status-im/keycard-pro/(threads)

Thread 14 (2025-03-18):

Timeout too long if card inserted wrong way

bitgamma, 2025-03-18:
Turning the device one with the card in the wrong direction seems to have a longer than expected timeout before an error appears

bitgamma, 2025-05-13:
the culprit was a 30 second timeout in the smartcard code, now lowered to 1 second

Closed 2025-05-13.

Thread 20 (2025-04-09):

Implement e-label

bitgamma, 2025-04-09:
details tbd

guylouis, 2025-07-13:
**Context**
Products sold in europe and in the usa need a list of mandatory mentions on the product like
CE mark
barred bin
model number
name of the manufacturer
power rating
serial or lot number

Products who have a display can use the display to show these informations instead of printing them on the product.

**For Shell**
On Shell we will have the CE mark and trashed bin. Both on the PCB behind the battery. But not the rest of theinformations.

So we have to create a menu, accessible when the product is unlocked.

**To be confirmed (I will be able to conifrm week of 28/7/2025)**
- place and name for the menu (probably will be something like settings/device/legal) I have to check what's the tolerated maximum number of clicks to get to the menu
- content of the screen. Hopefully it will be only text (since CE and barred bin are already on the product), and the only variable one will be the SN of the device

guylouis, 2025-07-30:
**Regarding where to put this elabel, the reference docs are**

https://fcc.report/FCC-ID/A4RGUIK2/5042986.pdf

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

So I suggest to put it here: settings/device/**regulatory label**

**Regarding the content of the label it should be**

"
Brand: Keycard
Model: Shell
Input: 5V DC, 1A
Manufacturer: Status Research and Development Am Zirkus 2, D-10117 Berlin, Germany
Made in China
Serial number:xxxxxxx
"

note: actually I think the input could take up to 1.5A but we can play it safe and leave 1A here

bitgamma, 2025-08-11:
done

Thread 23 (2025-04-09):

support SeedQR and text-mnemonic QR

bitgamma, 2025-04-09:
add support for https://github.com/SeedSigner/seedsigner/blob/dev/docs/seed_qr/README.md and/or plaintext mnemonic QR.

bitgamma, 2025-06-25:
proposed (and currently implemented) interaction. The default choice is "with passphrase" since it seems to be very common to set one when using SeedQR.

Please review @xAlisher @guylouis:

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

xAlisher, 2025-06-26:
@guylouis @bitgamma

Following up on the conversation here:
[https://discord.com/channels/1366754869561790474/1387350462117712045/1387690470423007333](https://discord.com/channels/1366754869561790474/1387350462117712045/1387690470423007333)

I’m aligned with @bitgamma on the minor copy updates.

User flows have been added to Figma:
[https://www.figma.com/design/I4NT4JGHDEVSQ2yo5Z4mju/Shell-OS?node-id=5295-93739\&t=PKWxt5CPmQwZbo0K-1](https://www.figma.com/design/I4NT4JGHDEVSQ2yo5Z4mju/Shell-OS?node-id=5295-93739&t=PKWxt5CPmQwZbo0K-1)

Great job on this feature! 👏

Thread 27 (2025-05-06):

Improve T=1 support

bitgamma, 2025-05-06:
Smartcard from manufacturers other than NXP currently do not work properly with Shell. ATR and PPS seem to work, but T=1 blocks cannot be correctly exchanged, will have to check what's wrong.

Closed 2025-05-19.

Thread 29 (2025-05-14):

Update auto-complete interaction and feedback design

xAlisher, 2025-05-14:
### Title
Update auto-complete interaction and feedback design

---

### Description
The current auto-complete input flow is not intuitive for many testers.

**Reported by:** 9 testers

#### Key issues:
- It’s unclear what happens when users hold to save a word — most testers only understood it after experimenting.
- Selecting a suggested word feels confusing; several testers tried using arrow keys to confirm.
- Typing is slow and lacks visible feedback for how suggestions are selected or confirmed.

---

### Suggested improvements:
- Improve on-screen labels and titles for clarity
- Display a visible list of suggested words
- Add a walkthrough video or animation to onboarding materials
- Show a validation error (e.g. red text) if a user tries to confirm an invalid word

### Resources
https://www.figma.com/design/I4NT4JGHDEVSQ2yo5Z4mju/Shell-OS?node-id=0-1

xAlisher, 2025-05-24:
Plan Minimum
- Update wording to make expected behavior explicit.
- Improve readability of titles and the highlighted word segment.
- Clarify action label to reinforce what’s being confirmed.
- Increase space between cursor and word parts for readability

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

Plan Maximum

**Introduce an alternate suggestion input:**
- Show a full list of valid words to choose from.
- Reduce number active keys with every character selected to minimize navigation steps.

Overview
This update targets common tester friction in the current flow. Plan minimum is low-effort and already resolves major confusion. Plan maximum adds predictability and significantly faster word input.

Proposal: https://www.notion.so/Shell-input-improvements-14d8f96fb65c80f0bf76ff1ff1190570  (note: design and keyboard layout outdated)
Figma https://www.figma.com/design/I4NT4JGHDEVSQ2yo5Z4mju/Shell-OS?node-id=5055-140967&t=5ZdeBNICwB1bczF1-1

🙏👁️ @guylouis @bitgamma

xAlisher, 2025-05-24:
Error handling:
- Remove "Hold to" button

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

bitgamma, 2025-05-29:
extracted in #111  the more complete autocomplete solution

bitgamma, 2025-05-29:
implemented the minimum solution, however the "Hold to confirm label" actually doesn't fit in screen so I left the current label for the action label

bitgamma, 2025-06-04:
In code the space between navigation icon and screen border is 16px. The space between icon and label is 10px. I can decrease them if needed

Closed 2025-06-23.

Thread 30 (2025-05-14):

Standardize confirmation interaction using button 5 and OK button on virtual keyboard

xAlisher, 2025-05-14:
### Description
Several testers expected the center key (`5`) to act as a confirmation button, aligning with familiar patterns from TV remotes and keypad-based devices.

**Reported by:** 7 testers

#### Key issue:
- Users instinctively pressed button 5 to confirm actions during input flows.
- Current behavior is inconsistent and breaks expected interaction patterns.

### Suggested improvements:
- Map confirmation consistently to button 5 across keyboard interactions.
- Ensure the “OK” button performs the same role on relevant screens.

Closed 2025-09-08.

Thread 31 (2025-05-14):

Fix unpredictable focus behavior in virtual keyboard

xAlisher, 2025-05-14:
### Description
The current focus navigation in the virtual keyboard is unintuitive and frustrating for users.

**Reported by:** 7 testers

#### Key issues:
- Focus does not move as expected when navigating the keyboard.
- The current layout appears designed for symmetry rather than interaction flow.
- Testers often lost track of which key will be active or selected.

---

### Suggested improvements:
- Prioritize predictable navigation over visual symmetry.
- Align key positions to support consistent up/down/left/right movement.
- Consider visual or motion cues to reinforce active focus.

---

### Resources
https://www.figma.com/design/I4NT4JGHDEVSQ2yo5Z4mju/Shell-OS?node-id=0-1

guylouis, 2025-05-23:
I personally think option 2 makes more sense, but it's not either a blocker for release. It comes down to @bitgamma bandwidth, if it's like less than 2 days of work I'd do it before release. Otherwise I think we can either postpone or expect someone else in the community takes it

Closed 2025-06-03.

Thread 32 (2025-05-14):

Consider supporting T9-style or multi-tap input method

xAlisher, 2025-05-14:
### Description
Several testers expected a classic SMS-style input method, where each number key maps to multiple letters (e.g., button 1 circles through  A,B,C). The current input model does not meet this expectation and slows down entry for many users.

**Reported by:** 6 testers

#### Key issues:
- Testers instinctively expected to use multi-tap or classic T9 logic for typing.
- The current flow doesn’t align with familiar mobile or remote control inputs.
- This mismatch leads to user frustration and slower task completion.

---

### Suggested improvements:
- Implement a T9-style layout or offer it as an optional input mode.
- Visually indicate available letters per button.
- Consider pairing with predictive suggestions for efficiency.
- Consider updating physical buttons with related letters

---

### Resources
https://www.figma.com/design/I4NT4JGHDEVSQ2yo5Z4mju/Shell-OS?node-id=0-1

Thread 33 (2025-05-14):

Fix Shell shutdown caused by loose Keycard connection

xAlisher, 2025-05-14:
### Description
Shell powers off when the Keycard moves slightly during use. This disrupted testing sessions and led testers to question the device’s reliability.

**Reported by:** 5 testers

#### Key issues:
- Card doesn’t stay securely in place.
- Minor shifts in the card's position result in an unexpected power-off.

---

### Suggested improvements:
- Improve card slot tension to ensure stable connection.
- Add visual feedback to confirm successful card insertion.
- Explore mechanical design changes to prevent unintentional disconnection.

guylouis, 2025-05-23:
taken into account in the various mechanical adjustments decided based on those alpha/er prototypes

the changes are documented here

[Mechanical adjustments to Shell ER_alpha stage 05 2025.pdf](https://github.com/user-attachments/files/20414238/Mechanical.adjustments.to.Shell.ER_alpha.stage.05.2025.pdf)

Thread 34 (2025-05-14):

Ensure consistent navigation and visible Back button across all screens

xAlisher, 2025-05-14:
### Description
Testers experienced confusion due to inconsistent navigation patterns and missing “Back” buttons on several screens.

**Reported by:** 5 testers

#### Key issues:
- “Back” button not present or visible on all screens.
- Inconsistent navigation makes it hard to return to the previous step.
- Users were unsure how to exit or undo actions in certain flows.

---

### Suggested improvements:
- Standardize the presence and placement of the Back button across all screens.
- Use consistent icons or labels for navigation actions.
- Add visual guidance to reinforce expected flows and transitions.

---

### Resources
https://www.figma.com/design/I4NT4JGHDEVSQ2yo5Z4mju/Shell-OS?node-id=0-1

bitgamma, 2025-05-28:
lgtm

Closed 2025-05-28.

Thread 36 (2025-05-14):

Improve clarity of card orientation and insertion depth

xAlisher, 2025-05-14:
### Description
Users were uncertain about how far to insert the Keycard and which direction it should face. The current design provides limited tactile or visual guidance, leading to hesitation and errors during setup.

**Reported by:** 4 testers

#### Key issues:
- No clear indicator for proper card orientation.
- Lack of tactile or visual confirmation when the card is fully inserted.
- Some users feared inserting the card incorrectly or not far enough.

---

### Suggested improvements:
- Add visual cues (icons, arrows, notches) to indicate correct card direction and depth.
- Consider modifying slot design so a portion of the card remains visible after insertion.
- Include clearer onboarding steps or animations to guide first-time users.

xAlisher, 2025-05-19:
3 points of contact for chip orientation and insertion depth
- paper
- shape
- quick start guide

 For chip orientation
- it's not a Keycard or it's not inserted the right way

Thread 37 (2025-05-14):

Improve screen brightness for better visibility in varied lighting

xAlisher, 2025-05-14:
### Description
Testers reported that the screen was difficult to read in bright or direct lighting conditions. Low brightness affected usability, especially outdoors or in well-lit rooms.

**Reported by:** 3 testers

#### Key issues:
- Text and UI elements were hard to see in some environments.
- The screen didn’t adapt well to different lighting conditions.
- Diminished readability affected the overall impression of hardware quality.

---

### Suggested improvements:
- Enhance screen backlight strength or contrast.
- Explore using a brighter display panel.

guylouis, 2025-05-23:
after investigation, we confirmed that the transistor was not conducting properly because the control voltage (gate/base) was insufficient at 1.8 V

this happened because because between P2 (which was OK in terms of brightness) we changed the transistor reference, going back to the initial transistor on modified ER the backlight is OK

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

Thread 38 (2025-05-14):

Align physical button layout with on-screen label expectations

xAlisher, 2025-05-14:
### Description
Some testers expected the physical buttons to align directly beneath the on-screen labels. The current layout — where buttons are placed in the final row — caused mismatch and hesitation during interaction.

**Reported by:** 4 testers

#### Key issues:
- Mismatch between physical button placement and on-screen cues.
- Users looked for labels directly above buttons but found a disconnect.
- This slowed down interactions and created uncertainty during selection.

---

### Suggested improvements:
- Consider adjusting button placement to match the visual layout of the UI.
- Alternatively, improve visual guidance by clearly associating labels with their corresponding buttons.
- Highlight states and iconography to reinforce correct button-label mapping.

Thread 39 (2025-05-14):

Make battery easier to remove through design adjustment

xAlisher, 2025-05-14:
### Description
Several testers found it physically difficult to remove the battery from the device. The current design does not provide enough leverage or grip to extract it comfortably.

**Reported by:** 3 testers

#### Key issues:
- Battery is tightly fitted and lacks a convenient way to remove it.
- No designated area to grip or push the battery out.
- Frustration during basic maintenance impacts perceived usability.

---

### Suggested improvements:
- Add a notch, groove, or indentation to assist with finger grip.
- Consider introducing a pull tab or tool-free removal mechanism.
- Ensure that battery maintenance feels simple and intentional.

xAlisher, 2025-05-19:
It's possible to remove the battery with the card.
Add this to the doc.

guylouis, 2025-05-23:
conclusion is indeed that we won't make changes to the plastic but document precisely how to remove the battery

Thread 40 (2025-05-14):

Improve case material and surface finish for higher perceived quality

xAlisher, 2025-05-14:
### Description
Testers noted that the current plastic finish of the Shell case felt cheap. Several people expressed a desire for a more premium or tactile material.

**Reported by:** 3 testers

#### Key issues:
- Case surface feels generic or less durable.
- Glossy or smooth finish may reduce grip and aesthetic appeal.
- Material choice influences first impressions of quality.

---

### Suggested improvements:
- Explore matte finishes.
- Consider material swaps that improve grip and reduce glare.
- Test finish options with users to balance durability and feel.

guylouis, 2025-05-27:
On alpha products (ER) we use ABS plastic but the grain (finish) is not applied on the steel mold. That's why the surface has some marks. The finish is applied at the very last moment when all changes on the steel mold have been done.

Once it is applied, the plastic when injected will be perfect in terms of finish and quality

Thread 41 (2025-05-14):

Improve font legibility by increasing size

xAlisher, 2025-05-14:
### Description
A few testers mentioned that the current font size is too small, making it harder to read content comfortably during use.

**Reported by:** 3 testers

#### Key issues:
- Font appears too small on certain screens.
- Difficult to read for users with less-than-perfect vision.
- Affects usability during onboarding and input flows.

---

### Suggested improvements:
- Increase default font size across the UI where possible.
- Offer an adjustable font size setting in preferences.

bitgamma, 2025-07-14:
font size increased in titles

Closed 2025-07-14.

Thread 44 (2025-05-14):

Consider switching to alphabetical keyboard layout for clarity

xAlisher, 2025-05-14:
### Description
Some testers found the QWERTY layout less intuitive, especially on a small device with limited keys. An alphabetical layout might offer better clarity for non-technical or first-time users.

**Reported by:** 2 testers

#### Key issues:
- QWERTY layout is less familiar to some users in this context.
- Alphabetical layout may reduce friction and improve discoverability.
- Device constraints make traditional keyboard patterns feel unintuitive.

---

### Suggested improvements:
- Offer an alphabetical keyboard layout as default or as an option.
- Test with both experienced and non-experienced users to validate layout clarity.
- Explore hybrid layouts optimized for hardware button constraints.

---

### Resources
https://www.figma.com/design/I4NT4JGHDEVSQ2yo5Z4mju/Shell-OS?node-id=0-1

Thread 45 (2025-05-14):

Clarify whether user is creating a new PIN or entering an existing one

xAlisher, 2025-05-14:
### Description
Testers were confused about whether they were supposed to **create a new PIN** or **enter an existing one** when interacting with the first screen of the device. The word “Set” was used, but was not easily visible or meaningful in context.

**Reported by:** 2 testers

#### Key issues:
- Ambiguity between PIN creation and PIN entry on first use.
- The label “Set” is unclear and lacks visual emphasis.
- Confusion at this critical step can lead to hesitation or input errors.

---

### Suggested improvements:
- Use clear, explicit text: “Create new PIN” vs. “Enter existing PIN.”
- Improve visibility and contrast of instructional text on the screen.
- Consider using a visual indicator or icon to differentiate the flows.

---

### Resources
https://www.figma.com/design/I4NT4JGHDEVSQ2yo5Z4mju/Shell-OS?node-id=0-1

bitgamma, 2025-05-28:
implemented

Thread 46 (2025-05-14):

Improve button feel — reduce press resistance for better usability

xAlisher, 2025-05-14:
### Description
Several testers reported that the hardware buttons on Shell felt too stiff or hard to press. The high resistance reduced comfort and created hesitation during interactions.

**Reported by:** 2 testers

#### Key issues:
- Buttons require too much force to register input.

---

### Suggested improvements:
- Soften the button mechanism to reduce required pressure.
- Explore alternative materials or switch types for improved feel.
- Aim for a balance between clicky feedback and comfortable usability.

bitgamma, 2025-05-14:
8 testers explicitly mentioned liking the current level of stiffness

Thread 47 (2025-05-14):

Improve packaging usability — box is difficult to open and remove Shell from

xAlisher, 2025-05-14:
### Description
Testers reported difficulty both opening the Shell packaging and removing the device from the box. These friction points negatively impacted the unboxing experience and first impressions of the product.

---

#### Key issues:
- Outer box lacks intuitive opening mechanism; users had to guess or apply force.
- The Shell device is tightly fitted with no clear way to lift it out.
- Risk of user frustration or device damage during unboxing.

---

### Suggested improvements:
- Redesign the box for easier opening (e.g. tear strip, pull tab, or clear indicators).
- Add a finger recess, ribbon, or lift tab to help remove the Shell device easily.
- Prototype revised packaging for smoother, one-handed unboxing experience.

guylouis, 2025-05-14:
working on providing an improved version
- same construction philosophy
- with more room inside, will facilitate grabbing stuff
- with higher quality feeling of the material

1st step is to decide if we can keep the black & orange type of design and improve the perceived quality. It's unsure while using corrugated paper that we can manage too, because of the edges

If we can't we'll have cardboard color material on which we will print our design. It will help have a cleaner looking edge.

guylouis, 2025-05-23:
strategy is to create a place to put the finger to lift up Shell and the papers

[KEYCARD_coffret_v1_23052025.pdf](https://github.com/user-attachments/files/20414222/KEYCARD_coffret_v1_23052025.pdf)

guylouis, 2025-07-14:
packaging had been improved, see the die cut below
samples to be received end of July - early August max

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

Closed 2025-06-30.

Thread 48 (2025-05-14):

Clarify how to add Shell as a hardware wallet in MetaMask

xAlisher, 2025-05-14:
### Description
Testers were confused when attempting to connect Shell as a hardware wallet in MetaMask. MetaMask requires users to first create or import a hot wallet before they can add a hardware wallet — a step that’s not obvious to first-time users.

---

#### Key issues:
- Users didn't understand why MetaMask wouldn't let them add Shell directly.
- Lack of guidance led to friction and unnecessary troubleshooting.
- MetaMask UX assumption (hot wallet first) was not communicated clearly.

---

### Suggested improvements:
- Mention this requirement during Shell onboarding when prompting users to connect to MetaMask.
- Add a tip or note in Shell’s help documentation.
- Reach out to the MetaMask team with a proposal to improve or clarify this flow on their end.

Thread 49 (2025-05-14):

Improve readability of word prompt during backup flow

xAlisher, 2025-05-14:
### Description
During the backup process, users found it unclear which word they were expected to input. The current title bar, which displays the word number, is not easily readable due to low contrast.

---

#### Key issues:
- Word number (e.g. “Word 5”) is hard to see against the background.
- The label lacks contrast and visibility, leading to hesitation and confusion.
- Users are unsure which word they’re confirming or typing.

---

### Suggested improvements:
- Increase the contrast of the title bar
- Consider moving the word number to a more visible location, such as below the title
- Explore adding visual cues (like progress dots or highlighting) to reinforce the step number.

---

### Resources
https://www.figma.com/design/I4NT4JGHDEVSQ2yo5Z4mju/Shell-OS?node-id=0-1

xAlisher, 2025-05-24:
Suggest improving visibility without disrupting layout by:

- Increasing the title font size (may create slight tension in other areas, but it’s manageable).
- Boosting contrast between title text and background by brightening the style.

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

Bonus idea:
- To improve predictability, we could display the number of remaining steps to complete the flow.

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

🙏👁️ @bitgamma @guylouis

bitgamma, 2025-05-28:
@xAlisher lgtm, but I see in the figma design that some title needs to be changed because they don't fit with the larger font size.

Also, I see highlighted words/menus are now using white font instead of black. Is this change part of this issue?

Thread 50 (2025-05-14):

Clarify behavior of Cancel button on word input screen

xAlisher, 2025-05-14:
### Description
Testers were unsure what would happen if they pressed the “Cancel” button during the word input screen in the backup flow. The lack of explanation caused hesitation and fear of losing progress.

---

#### Key issues:
- “Cancel” button lacks contextual clarity — does it exit the flow, go back, or discard progress?
- Uncertainty at this step creates friction and user anxiety.
- No confirmation or explanation is provided when the button is pressed.

---

### Suggested improvements:
- Add a short label or tooltip to clarify what “Cancel” will do.
- Consider prompting a confirmation modal if pressing “Cancel” would result in data loss or reset.
- Use more descriptive text (e.g., “Go back” or “Exit backup”) if appropriate.

---

### Resources
https://www.figma.com/design/I4NT4JGHDEVSQ2yo5Z4mju/Shell-OS?node-id=0-1

phift, 2025-05-29:
Maybe that's what you mean by backup flow. But in the `Import recovery phrase` screen, 'c hold to exit' is similarly confusing, because holding c doesn't 'exit' the flow, but it returns to the previous screen

bitgamma, 2025-07-14:
labels have been adjusted accordingly

Closed 2025-07-14.

Thread 51 (2025-05-14):

Add support for displaying ABI data after scanning transaction QR

xAlisher, 2025-05-14:
### Description
Testers expressed interest in seeing decoded ABI (Application Binary Interface) data after scanning a transaction QR code. This would help verify the intent of a transaction before signing, especially for smart contract interactions.

#### Key issues:
- Lack of transparency into what the transaction is doing.
- Users want to understand the method and parameters before signing.
- No decoded ABI data currently shown in the signing flow.

---

### Suggested improvements:
- Parse and display ABI call data after scanning a transaction QR.
- Show method name, parameters, and values in a readable format.
- Include this as an optional step for advanced users.

---

### Resources
https://www.figma.com/design/I4NT4JGHDEVSQ2yo5Z4mju/Shell-OS?node-id=0-1

Thread 52 (2025-05-14):

Fix link to duress PIN documentation

xAlisher, 2025-05-14:
### Description
The link to the duress PIN documentation at [https://keycard.tech/duress_pin](https://keycard.tech/duress_pin) is currently broken or not live. Testers who try to learn more about this security feature encounter a dead page

**Reported by:** Multiple testers

#### Key issues:
- The link to duress PIN documentation leads to a non-functional page.
- Users are left without guidance on how duress mode works.
- Breaks the user flow during onboarding or help searches.

---

### Suggested improvements:
- Publish or finish the content at https://keycard.tech/duress_pin.

Closed 2025-08-11.

Thread 53 (2025-05-14):

Fix incorrect navigation when exiting “Generate New Key” flow

xAlisher, 2025-05-14:
### Description
When users exit the “Generate New Key” flow, they are redirected to the wrong screen. This creates confusion and breaks the expected flow continuity.

---

#### Key issues:
- Exiting the key generation process doesn’t return the user to the intended screen.
- Unexpected navigation causes users to feel lost or uncertain about their progress.
- Breaks consistency with the rest of the onboarding flow.

---

### Suggested improvements:
- Ensure exit from the “Generate New Key” flow returns the user to the correct previous screen.
- Review and test all exit paths for accuracy and UX coherence.

---

### Resources
https://www.figma.com/design/I4NT4JGHDEVSQ2yo5Z4mju/Shell-OS?node-id=0-1

xAlisher, 2025-05-19:
Let's test it

Thread 54 (2025-05-14):

Allow users to purchase Shell with cryptocurrency

xAlisher, 2025-05-14:
### Description
Testers expressed interest in buying Shell using crypto. Offering a direct crypto payment option would align with the values of the target audience and streamline the purchasing experience.

---

#### Key issues:
- No visible option to purchase Shell using crypto.
- Credit card-only checkout may exclude privacy-conscious or Web3-native users.
- Missed opportunity to align purchasing flow with the product’s ethos.

---

### Suggested improvements:
- Enable crypto payments via dedicated platform
- Highlight crypto payment option on the main landing and checkout pages.
- Allow pre-orders and community discounts through crypto-first channels.

Thread 55 (2025-05-14):

Clarify that “Get signature” in MetaMask triggers QR scanning flow

xAlisher, 2025-05-14:
### Description
Tester was confused by the “Get signature” button in MetaMask, as it’s not clear that clicking it will initiate the QR code scanning process with Shell. The lack of context causes hesitation and interrupts the expected signing flow.

---

#### Key issues:
- The label “Get signature” doesn’t indicate that it will trigger QR scanning.
- Users are unsure what to expect after clicking the button.
- Lack of explanation increases friction and makes the process feel opaque.

---

### Suggested improvements:
- Reach out to the MetaMask team to suggest a more descriptive label (e.g. “Scan to Sign” or “Continue with Hardware Wallet”).
- Include clear instructions in Shell documentation and onboarding to explain the MetaMask signing flow.

xAlisher, 2025-05-24:
To improve clarity and better align with MetaMask’s “Get Signature” prompt, I suggest updating the title on the TX QR screen.

Before:
“Scan signature QR with Wallet”

After:
“Show signature QR to your wallet”

This reinforces the correct direction of action and helps users interpret what’s happening more intuitively.

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

Thread 56 (2025-05-14):

Chevron-right inside the circle icon misinterpreted as  chevron on keypad

xAlisher, 2025-05-14:
### Description
Testers confused the chevron-right icon inside an orange circle with the physical chevron key on the keypad. This led to hesitation and incorrect inputs. The blending of icon roles reduced clarity in the interface.

#### Key issues:
- Chevron inside the orange circle is visually similar to the keypad's left-arrow button.
- Users mistakenly interpret it as a hardware control rather than an on-screen indicator.
- Inconsistent icon behavior breaks visual expectations.

---

### Suggested improvements:
- Consider using a plain orange circle for confirmation actions (OK), without overlaying the chevron.
- Keep all chevron icons on-screen consistently white.
- Ensure visual roles between hardware keys and on-screen symbols are clearly separated.

---

### Resources
https://www.figma.com/design/I4NT4JGHDEVSQ2yo5Z4mju/Shell-OS?node-id=0-1

xAlisher, 2025-05-23:
OK button states simplified and unified. Now we'll have only two states. Default and long press.

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

I need one more pair of eyes for feedback and review.
@guylouis @bitgamma

guylouis, 2025-05-23:
looks good!
maybe write it somewhere in the doc in a 'navigation' part of the faq

bitgamma, 2025-05-23:
looks good to me too

bitgamma, 2025-05-28:
done

Closed 2025-05-28.

Thread 58 (2025-05-14):

Allow adding a password to mnemonic

bitgamma, 2025-05-14:
often called the 13th or 25th word, we could allow the user to add a password the mnemonic phrase. This is especially useful if we implement #23 since it is relatively common to use a password in this case.

This step would happen during onboarding of a new card when:

- importing an existing mnemonic (either keyboard or QR)
- generating a new mnemonic, after backup and before the keys are actually loaded

bitgamma, 2025-06-09:
@xAlisher

my understanding is that in both generate mnemonic and import mnemonic the menu where you select the mnemonic length will become something like:

12 words
12 words + pass
24 words
24 words + pass

and that after the mnemonic has been entered or backed up the user will enter the pass.

Is this also how you see the flow? If that's the case I will start implementing this.

bitgamma, 2025-06-10:
Implemented the feature so that it at least works. For UI I simply modified the mnemonic length selection menu and added, in case an option with passphrase has ben selected, a final screen to input the passphrase. Feel free to revise this in any way

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

xAlisher, 2025-06-23:
@bitgamma design updated

Import recovery phrase https://www.figma.com/design/I4NT4JGHDEVSQ2yo5Z4mju/Shell-OS?node-id=5235-62008&t=4bPH3kMTDniDkBOV-1
Generate keys
https://www.figma.com/design/I4NT4JGHDEVSQ2yo5Z4mju/Shell-OS?node-id=214-58571&t=4bPH3kMTDniDkBOV-1

Closed 2025-06-23.

Thread 59 (2025-05-14):

Improve autocomplete prioritization to favor longer words

xAlisher, 2025-05-14:
### Description
Testers noted that Shell’s autocomplete often prioritizes shorter or less relevant words, even when longer, more complete matches are available. This results in more manual input and interrupts the typing flow.

#### Key issues:
- Autocomplete tends to suggest short or partial words first.
- Users expect longer, more specific matches to rank higher.
- Current ordering may lead to unnecessary corrections or delays.

---

### Suggested improvements:
- Adjust autocomplete algorithm to favor longer, more complete word matches.
- Test updated prioritization on common wallet recovery words

---

### Resources
https://www.figma.com/design/I4NT4JGHDEVSQ2yo5Z4mju/Shell-OS?node-id=0-1

Thread 60 (2025-05-14):

Clarify how to connect Shell to Rabby — no QR-based option visible

xAlisher, 2025-05-14:
### Description
Testers found it difficult to connect Shell to Rabby, as the wallet connection UI does not clearly show a QR-based option. Shell is not listed as a branded wallet, and there is no generic “Connect with QR” entry point, leading to confusion.

---

#### Key issues:
- Rabby does not show a generic QR-based connection option.
- Shell is not yet listed as a supported or branded wallet.
- Users struggle to find a compatible path for connection.

---

### Suggested improvements:
- Reach out to the Rabby team to request inclusion of Shell or a “Connect via QR” option.
- In the meantime, add a clear note in Shell documentation to guide users through the available workaround.
- Consider providing step-by-step instructions or visuals in onboarding for connecting via Rabby.

---

### Resources
https://www.figma.com/design/I4NT4JGHDEVSQ2yo5Z4mju/Shell-OS?node-id=0-1

Closed 2025-07-28.

Thread 61 (2025-05-14):

Add confirmation feedback after factory reset

xAlisher, 2025-05-14:
### Description
After performing a factory reset, the device does not provide any confirmation or feedback to indicate that the reset was successful. This leaves users unsure whether the action completed correctly.

---

#### Key issues:
- No success message, visual cue after reset.
- Users are left uncertain about whether the reset worked.
- Can lead to repeated attempts to enter previous PIN or loss of confidence in the process.

---

### Suggested improvements:
- Display a clear confirmation screen (e.g. “Keycard has been reset”) after the reset completes.
- Optionally add a success icon for reassurance.
- Then redirect users back to the welcome/setup screen after successful reset.

---

### Resources
https://www.figma.com/design/I4NT4JGHDEVSQ2yo5Z4mju/Shell-OS?node-id=0-1

xAlisher, 2025-05-21:
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

@guylouis @bitgamma  WDYT?

Closed 2025-05-28.

Thread 62 (2025-05-14):

Clarify wallet type selection (Ethereum, Bitcoin, Multichain)

xAlisher, 2025-05-14:
### Description
Testers were confused when asked to choose between Ethereum, Bitcoin, or Multichain wallets during setup. The options lacked context or explanation, making it unclear which one to pick.

---

#### Key issues:
- Users didn’t understand the differences between Ethereum, Bitcoin, and Multichain wallets.
- Lack of in-device guidance made this decision feel risky or arbitrary.
- No clear link to supported wallet features or compatibility.

---

### Suggested improvements:
- Add a brief description under each wallet type (e.g. “Ethereum: EVM-compatible chains”).
- Consider adding recognizable brand names (e.g. MetaMask, Rabby, OKX) to improve comprehension.
- Update documentation to explain each wallet type, use case, and compatibility in more detail.

---

### Resources
https://www.figma.com/design/I4NT4JGHDEVSQ2yo5Z4mju/Shell-OS?node-id=0-1

xAlisher, 2025-06-03:
- remove Sparrow
- remove multichain

xAlisher, 2025-06-23:
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

https://www.figma.com/design/I4NT4JGHDEVSQ2yo5Z4mju/Shell-OS?node-id=0-1&t=4bPH3kMTDniDkBOV-1

I'm suggesting to name most popular wallets right in the menu for better user experience.

@guylouis @bitgamma WDYT?

@cheny0 could you give me the list of wallets compatible with Shell sorted by popularity to add to this menu, please?

xAlisher, 2025-06-23:
https://www.figma.com/design/I4NT4JGHDEVSQ2yo5Z4mju/Shell-OS?node-id=53-19251&t=4bPH3kMTDniDkBOV-1

cheny0, 2025-06-25:
@xAlisher Here's a list in the current docs: https://keycard.tech/docs/supported-wallets#wallets-for-keycard. The "Multichain" QR code works for Bitget and backpack

guylouis, 2025-06-30:
I wouldn't trust this list too much, it was more a marketing list than a result of good testing

here's where we will track the result of the real testing
https://github.com/keycard-tech/keycard-shell/issues/81

guylouis, 2025-08-13:
So the entries will be:
Ethereum
Bitcoin
Bitcoin Multisig
Bitget

Bitcoin Testnet is present for now but will be removed before launch

guylouis, 2025-09-08:
I am unclear if it's ok like this (current implementation is ethereum, bitcoin, bitcoin multisig, bitget) or if we want to add more details in the list

Closed 2025-09-08.

Thread 63 (2025-05-14):

define keycard design for shell

guylouis, 2025-05-14:
When someone buys Shell, we will put 2 cards together within the box.

We need to define the packaging of these cards
- keycard logo be bottom front so that we see keycard logo when entering the card in shell
- black tone overall
- a shape should be present on the back that matches with Shell hole. This shape has several interest: care for the design (keycard and shell are perfect friends: they match :)), delimits a zone were the user could put a small sticker or write down with a marker a way to distinguish his cards, and finally helps remembering how (top/bottom) to insert the card.
- we want to keep our logistics wimple so this card will also be the one shipped to customers buying keycards without Shell

guylouis, 2025-10-03:
settled for this design [print_Keycard_K_icon_BLACK_V2.pdf](https://github.com/user-attachments/files/22676522/print_Keycard_K_icon_BLACK_V2.pdf)

Thread 66 (2025-05-14):

define exact content of the quick start 'card' printed in the box

guylouis, 2025-05-14:
content on alpha was:

front side

"Scan to get started
QR code
keycard.tech/start"

back side

"1 remove the back cover from keycard shell

2 install the battery in its slot

3 insert a keycard to turn on Keycard Shell
"

guylouis, 2025-05-30:
seems good to me, I guess the sensitive one is point 3. If one doesn't check the quick start guide then he must understand that he needs to push the card completely. So I guess point 3 should either
- have an illustration where we see the insertion top/bottom and a finger pushing all the way
- a text -> push card *all the way* or 'if your product doesn't turn on make sure you push the card all the way'

guylouis, 2025-07-13:
@Francesca-G

I think we're ready to design this, to print it also as part of the packaging
Could you do it when you have chance?

guylouis, 2025-07-28:
card updated by @Francesca-G

[TOKEA_carte_65x100mm.pdf](https://github.com/user-attachments/files/21468342/TOKEA_carte_65x100mm.pdf)

Closed 2025-07-28.

Thread 68 (2025-05-14):

message when inserting a card which is incompatible with keycard

guylouis, 2025-05-14:
can we review what happens if someone inserts a card without keycard applet, or with keycard applet but too old (applet < 3.1.0)

bitgamma, 2025-05-14:
sorry closed by mistake, but probably can be closed can't it?

guylouis, 2025-05-19:
some testers said the message was not super clear, may you confirm what it is in the code?

bitgamma, 2025-05-19:
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

guylouis, 2025-05-19:
we can close, I opened two issues for future improvements

not genuine: https://github.com/keycard-tech/keycard-shell/issues/72
old applet: https://github.com/keycard-tech/keycard-shell/issues/73

Closed 2025-05-19.

Thread 70 (2025-05-14):

Improve error message for unsupported Bitcoin Taproot transactions

xAlisher, 2025-05-14:
### Description
When attempting to sign a Taproot-based Bitcoin transaction using Shell and Unisat (e.g. for buying an ordinal on Magic Eden), the device displayed a misleading “wrong key pair” error. This happened even though the same Keycard worked for connecting to Unisat. The actual issue is related to Taproot being unsupported.

#### Context:
- Taproot is currently not supported.
- The transaction included Taproot components, leading to a signing failure.
- Error message displayed: “wrong key pair,” which does not explain the real cause.

---

### Suggested improvements:
- Update the error message to clarify that Taproot-based transactions are not supported.
- Suggested phrasing: _“This transaction uses a Taproot address, which is not supported yet.”_
- Optionally include a link to documentation or help page for supported address types.

---

### Notes:
Tested with:
- Shell + Unisat
- Magic Eden / Ordinal TX
- Switching to Segwit resolved the issue

---

### Resources
https://www.figma.com/design/I4NT4JGHDEVSQ2yo5Z4mju/Shell-OS?node-id=0-1

xAlisher, 2025-05-21:
> just update wording to a more generic error message to say that there is nothing we can sign here (it's not a question of keys)

But also could be a wrong key pair.
@guylouis @bitgamma WDYT?

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

guylouis, 2025-05-22:
seems good to me
how can we track all the things that need to be in the documentation ?
this is one for instance
any idea @cheny0 ?

cheny0, 2025-05-23:
@guylouis, what we are doing now seems to be good enough, which is to add the "documentation" label to relevant issues. When you want to check all documentation-related issues, you go to the project board and click on the "documentation" label. Then you'll see only issues with this label, like this https://github.com/orgs/keycard-tech/projects/1/views/1?filterQuery=label%3Adocumentation. WDYT?

guylouis, 2025-05-23:
great to hear!

bitgamma, 2025-05-28:
the subtext message is too long, otherwise I have to rework the entire info dialog to measure all text and calculate the vertical offsets before drawing, which I don't think it is worth. Let's omit the "Visit ..." part

Closed 2025-06-03.

Thread 76 (2025-05-19):

Update Shell packaging design

Francesca-G, 2025-05-19:
### Description

Update Shell packaging design

- **COLORS →** Natural cardboard color + orange 🟠
- **FLAPS →** need to be bigger and black (useful to protect the device)
- **GLOSS PRINT →** thicker lines, consider embossed gloss print to make it more visible
- **INSTRUCTION CARD →** Change QR code to lead to a START page for Shell (/start/shell)
- **CARD HOLDER →** change to a single piece of paper with 4 slits and a card on each side (no folds) - each card uses 2 of the slits on each side
- **INSIDE DIVIDER FOLD →** make the hole slightly bigger to make it easier to grab

-------------------------------------------------

### Order of things in the box ⬆️

1. DEVICE
2. INSTRUCTION CARD (STEP NUMBERS FACING UP)
3. KEYCARDS
*—————— FOLD DIVIDER ——————*
4. INSTRUCTION & SAFETY USER MANUAL
5. BATTERY + CABLE

guylouis, 2025-05-19:
we will need to reserve a place on the packaging to stick a sticker with the serial number
https://github.com/keycard-tech/keycard-shell/issues/80

guylouis, 2025-05-23:
[KEYCARD_coffret_v1_23052025.pdf](https://github.com/user-attachments/files/20412076/KEYCARD_coffret_v1_23052025.pdf) new prototype

guylouis, 2025-07-14:
packaging had been improved, see the die cut below
samples to be received end of July - early August max

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

Thread 78 (2025-05-19):

help users use Shell in a 100% airgaped manner

guylouis, 2025-05-19:
# context

Shell gets input (e.g. get a transaction, a new firmware, an updated database of erc-20, a challenge to verify it's genuine) with
- USB
- camera

One of the added value of Shell is that it can be used airgapped. One feature available in Shell is to disable data over USB, if you want to plug Shell to your computer to charge it and be sure that no data is travelling over the USB cable.

Firmware upgrade needs a lot of data to be downloaded (typically 150kB+) and it cannot be down reliably over QR.

# documentation

we should help users understand how to perform some operations if they want to keep airgapped
- charging:
      - charge with a standard power supply (no computer) you trust
      - go to settings and remove data connection from Shell if you don't trust the power source (computer etc.)
- firmware upgrade
      - explain that the firmware can be downloaded on github
      - downloaded onto a airgapped computer by USB
      - use this airgapped computer to update Shell

to be decided: how can we provide the right browser page and javascript for the airgapped computer to update shell? @bitgamma

Thread 82 (2025-05-20):

test bitcoin multisig

guylouis, 2025-05-20:

bitgamma, 2025-06-04:
currently popular MultiSig schemes for bitcoin need to be tested. Needs some research to understand what is currently relevant. @phift can you help with this?

phift, 2025-06-05:
## Possible implementation

Generation | On-chain format | Crypto primitive | What Keycard still needs | Difficulty on Keycard | Roll-out/Relevance
-- | -- | -- | -- | -- | --
1 | P2SH (legacy “3…”) | ECDSA CHECKMULTISIG | Nothing new cryptographically; just add P2SH redeem-script handling in the MCU parser. | Low – the secure element already does ECDSA; extra code is small. | Probably not needed
2 | P2WSH (native SegWit “bc1q…0…”) | ECDSA CHECKMULTISIG | Nothing. PSBT-v0 and current ECDSA engine are sufficient. | Low – ready today. | covers the vast majority of live multisig flows.
3a | P2TR script-path | Schnorr CHECKSIGADD | BIP-340 Schnorr signing + x-only pubkey export. | Medium – fits in JCOP4; ≈ 40 ms per sig. | Users keep the same MCU firmware; flash a new Java-Card applet
3b | P2TR key-path | MuSig2 (n-of-n key aggregation) | Schnorr + 2-round nonce storage per input + new PSBT keys. | Hard – needs persistent nonce slots and anti-reuse logic inside the card. | Could become relevant for a Shell v2 – once BIP 327 is final
3c | P2TR key-path | FROST (m-of-n threshold) | Secret-share setup + multi-round signing protocol. | Very hard on a single signer card; heavy state management. | Probably unnecessary for > 95 % of users in 2025; better served by an external coordinator later

1. First step: SegWit native multisig - P2WSH sortedmulti (Generation 2)

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

2. Legacy P2SH multisig (Generation 1) is optional: could support, but it burns 15 % more bytes per spend and very little new infrastructure still requires it

bitgamma, 2025-06-05:
Now can correctly pair with Sparrow, however PSBT parsing needs to be extended to properly support this kind of transactions

phift, 2025-06-06:
The setup in Sparrow works! Haven't tested tx, though.

Thread 83 (2025-05-21):

add alpha build design files to github

guylouis, 2025-05-21:
alpha build corresponds to ER (engineering run)
we built 20 products, delivered end of April 2025
need to update all design files (hardware, casing) on github

guylouis, 2025-05-23:
done https://github.com/keycard-tech/keycard-shell/tree/master/hardware/
under P2 prototypes folder

there are two folders
- one with a step file with the full design including the electronics. Can be used to make very nice renders btw.
- one where for each plastic piece: a step file + a 2D file with all dimensions and tolerances

Thread 86 (2025-05-21):

add development board hw design in github

guylouis, 2025-05-21:
we need developers to be able to build their own development board if they want to

share:
- schematics
- pcb layout (gerbers)
- bill of material

guylouis, 2025-08-13:
somehow blocked because of budget restrictions
it would be awesome to find a contributor who's willing to work on this

Thread 95 (2025-05-24):

Improve message for cases when it's not clear if it not Keycard  or Keycard inserted the wrong way

xAlisher, 2025-05-24:
Issue:
Improve error messaging when the card is unreadable due to ambiguity—it's currently unclear whether the problem is that the user is not using a Keycard, or that the Keycard is inserted incorrectly.

Current behavior:
The message shown is too generic and doesn’t guide the user toward resolving the issue effectively.

Expected behavior:
A clearer message that covers both potential causes, e.g.:
“Can’t read the card. Make sure you’re using a Keycard and that the chip is facing the right way.”

Closed 2025-05-28.

Thread 101 (2025-05-26):

Add Shell testimonials to keycard website

phift, 2025-05-26:
### Situation

We show plenty of specs, but zero social proof. A tiny testimonial block (3–5 short quotes) on both the homepage (`/`) and the Keycard Shell page (`/keycard-shell`) should lift trust and conversion.

---

### What to do

1. **Create one reusable component** – `Testimonials.tsx` (lives in `src/app/_components/`).
2. **Insert it**

* On `keycard-shell/page.tsx`: right above the final **Pre-order** CTA.
* On the homepage: between the header section and comparison table.
3. **Content**

* We can get from a couple of early testers we already had!

Thread 99 (2025-05-26):

[Doc] Change the Shell battery

cheny0, 2025-05-26:
As mentioned in https://github.com/keycard-tech/keycard-shell/issues/39, when removing the battery, you need to use the card

Closed 2025-08-01.

Thread 111 (2025-05-29):

Implement faster autocomplete input

bitgamma, 2025-05-29:
Introduce an alternate suggestion input:

- Show a full list of valid words to choose from.
- Reduce number active keys with every character selected to minimize navigation steps.

Overview
This update targets common tester friction in the current flow. Plan minimum is low-effort and already resolves major confusion. Plan maximum adds predictability and significantly faster word input.

Proposal: https://www.notion.so/Shell-input-improvements-14d8f96fb65c80f0bf76ff1ff1190570 (note: design and keyboard layout outdated)
Figma https://www.figma.com/design/I4NT4JGHDEVSQ2yo5Z4mju/Shell-OS?node-id=5055-140967&t=5ZdeBNICwB1bczF1-1

bitgamma, 2025-06-13:
preliminary implementation included in 0.9.17. Navigation skipping disabled letters still missing but the rest only needs some polishing and resolving the two points above

Closed 2025-06-23.

Thread 112 (2025-05-29):

Add possibility to correct words on Invalid phrase entered screen

phift, 2025-05-29:
### Description
When users enter an invalid phrase during the recovery phrase input process in the backup flow, but doesn't notice until after the 12th word, on the `Invalid phrase entered` screen, they are forced to restart from the beginning.
This creates frustration, especially when the error is minor (e.g., a single incorrect word). Allowing users to navigate back to a specific word instead of restarting would improve the user experience.

---

#### Key issues:
- Restarting the entire phrase input process for a single error is inefficient and frustrating
- No option exists to edit or revisit a specific word in the phrase
- Users may abandon the process due to repetitive restarts, increasing user friction

---

### Suggested improvements:
- Add navigation controls similar to the current `Import seed phrase` flow https://github.com/keycard-tech/keycard-shell/issues/50 - to allow users to revisit and edit specific words in the phrase

---

### Resources
https://www.figma.com/design/I4NT4JGHDEVSQ2yo5Z4mju/Shell-OS?node-id=0-1

bitgamma, 2025-06-03:
my proposal is to go back to the input of the first word, without deleting the previously inserted words, which will be presented as auto-complete. This way the user reviews each word and corrects the wrong one(s) - just long-pressing OK on correct ones. This consistently requires 12 or 24 long-presses of OK + the input of any correction to finish the flow.

 I think this is better than restarting from the last word, since this would require navigating backward to find the error and then all the way forward again to get to the last word, potentially doubling the number of key presses required

@phift @xAlisher wdyt?

xAlisher, 2025-06-03:
Cool! +1

phift, 2025-06-03:
Sounds good!

Closed 2025-06-16.

Thread 117 (2025-06-19):

Create the Help page on the Keycard website

cheny0, 2025-06-19:
- We need to add a new page for user documentation with the url `keycard.tech/help`. This is the Figma file: https://www.figma.com/design/RSszWiHjK6os09PEDmJ0gR/Website---Keycard?node-id=4986-8236&t=Peq57Pppaxz3j2gj-4
- This is the Figma file for visual elements in articles: https://www.figma.com/design/RSszWiHjK6os09PEDmJ0gR/Website---Keycard?node-id=4271-17862&t=Peq57Pppaxz3j2gj-4 (Elements that involve non GitHub-flavored Markdown components are not priorities)
- Update the current documentation URL and website footer

xAlisher, 2025-07-28:
@felicio please share with us how it's going

xAlisher, 2025-08-06:
> [@xAlisher](https://github.com/xAlisher) what release date are you targeting?

@guylouis question for you 🙏

guylouis, 2025-08-06:
I expect Shells to be shipped in early 12/2025
For information, delays came from the battery certification :(

guylouis, 2025-10-03:
not sure: what's preventing to close this? @jkbktl

Closed 2025-10-03.

Thread 121 (2025-06-20):

Verify authenticity of Shell

xAlisher, 2025-06-20:
Create user flow of Shell Verification.
Start point https://shell.keycard.tech/verify
Linked with Quick Start Guide.

Parent issue:: https://github.com/keycard-tech/keycard-shell/issues/110

xAlisher, 2025-07-28:
@guylouis @Rsttskyy Let's test!

Thread 136 (2025-07-10):

Create unified UX to update firmware and token db via cable

xAlisher, 2025-07-10:
Following this discussion it was agreed to combine updating of firmware and token DB in one flow.

https://discord.com/channels/1366754869561790474/1392436342830530653/1392436347117244518

Rsttskyy, 2025-07-12:
Figma
https://www.figma.com/design/RSszWiHjK6os09PEDmJ0gR/Website---Keycard?node-id=7598-39562&t=7wBBQi0Sogu5kAOM-1

Prototype

Lottie animation
Demo - https://soft-branding-758712.framer.app/

Code:
`<script
  src="https://unpkg.com/@lottiefiles/dotlottie-wc@0.6.2/dist/dotlottie-wc.js"
  type="module"
></script>

<dotlottie-wc
  src="https://lottie.host/0ab81f68-e20a-446d-9363-b897ff67bd50/cLYIbtLguC.lottie"
  style="width: 590px;height: 344px"
  speed="1.6"
  autoplay
  loop
></dotlottie-wc>`

Rsttskyy, 2025-07-12:
Ultra wide screen layout behavior
https://www.figma.com/design/RSszWiHjK6os09PEDmJ0gR/Website---Keycard?node-id=7833-16867&t=i0W6WuJrkITjxoUF-1

Demo (resize window to see behavior)
https://soft-branding-758712.framer.app

Thread 137 (2025-07-10):

Create dedicated web page for "Full air-gapped update" with instructions and links.

xAlisher, 2025-07-10:
Create dedicated web page for "Full air-gapped update" with instructions and links and connect it to Update landing.

Draft of the content.

## Update Shell in full-airgapped mode

If you’d like your Keycard Shell to *never* touch the internet, follow these instructions to update it in a fully offline environment.

### 1. Prepare a disconnected device

Use a laptop or PC that has **never been connected to the internet**. This ensures it’s free from malware, spyware, or suspicious software.

### 2. Download the standalone updater

This app runs in an offline browser and allows you to connect your Keycard Shell and transfer updates.

**Select your operating system**:

* macOS
* Windows
* Linux

**Download** (version x.x.x)

### 3. Download the updates you’d like to install

* **Token database**
* **Firmware update**

### 4. Prepare your USB stick

Copy the downloaded files to a USB stick.

### 5. Update your Keycard Shell

1. Insert the USB stick into the offline device
2. Launch the standalone updater
3. Unlock your Keycard Shell and connect it via the supplied USB-C cable
4. Select the update files
5. Follow the instructions on the Shell screen

If you have any questions or run into issues, check out the help article (link) or ask in our Discord community (link).

Closed 2025-07-28.

Thread 138 (2025-07-10):

Update visual style of standalone updater

xAlisher, 2025-07-10:
Update visual style and assets of standalone updater to match with Keycard Shell website visual style.
Link to current version: https://github.com/choppu/kshell-updater

Rsttskyy, 2025-07-28:
https://www.figma.com/design/RSszWiHjK6os09PEDmJ0gR/Website---Keycard?node-id=6088-46702&t=uQ8mPUJbtZCPFsW3-1

xAlisher, 2025-07-28:
Review UI details with @Rsttskyy

choppu, 2025-10-04:
Yes, this one can be closed. This one is already implemented.

Rsttskyy, 2025-10-05:
Icon updated
https://www.figma.com/design/RSszWiHjK6os09PEDmJ0gR/Website---Keycard?node-id=6987-6811&t=tBQqcyfvaxFwOYsE-1

Changes:
- Clear case added
- orange bg changed to black

Reason: orange not works visually good combined with clear case.

Closed 2025-10-04.

Thread 139 (2025-07-12):

Have a .stl project of Shell on printable.com

guylouis, 2025-07-12:
The current files (steps) we have for Shell have been designed and optimized for plastic injection in our steel mold. If we want diy home builders to print a casing and use it with their electronics, we can help them by
- exporting the designs to a .stl files
- check/experiment/modify them to make sure the assembly works
- upload them on printable.com

xAlisher, 2025-07-14:
I'm in process of communication with Printables

xAlisher, 2025-08-11:
Printables do not reply.

Considering alternatives.

Thingiverse – The original big repository for 3D printing files, still widely used.

Cults3D – Popular with designers selling or freely sharing STL and other files.

Thangs – 3D model search and hosting with collaboration tools.

Libre3D – Fully open-source repository for 3D printable models.

Thread 151 (2025-07-30):

design and print sample of the regulatory leaflet

guylouis, 2025-07-30:
For regulatory reasons in europe, usa, and canada we need to print a leaflet that we will put in Keycard shell box.

This leaflet includes
- use and care recommendations for the product
- warnings for the battery
- european regulatory declaration
- usa regulatory declaration
- canada regulatory declaration

Here's a draft for the content of the leaflet https://docs.google.com/document/d/1JTA68iDlfdyYfmAgcMc36htxLo5xAx9b8aHBHjhYCi8/edit?usp=sharing

guylouis, 2025-08-20:
These suppliers tend to ask us to provide full detail about the formats we want, so @Francesca-G may you put the 6 pages just like the picture above on one sheet
- printed only on the front (no back printing)
- same folding idea (we can use the picture above to illustrate the folding we want)
- as for the size let's consider a size that makes it compatible with putting it on the top compartment (but I think we will put it on the bottom compartment), it leaves us some flexbility.

Thanks!

Francesca-G, 2025-08-22:
- Size when the leaflet is close: 65x100mm (same as Quick Start Guide card)
- Total size of the leaflet (6 pages): 195x200mm

[Regulatory_Leaflet_195x200.pdf](https://github.com/user-attachments/files/21935236/Regulatory_Leaflet_195x200.pdf)

Closed 2025-09-08.

Thread 173 (2025-09-27):

Unable to connect to Rabby desktop/extension on Framework 16

xAlisher, 2025-09-27:
I'm flagging an issue I encountered while trying to connect Rabby (both desktop and extension) to Keycard Shell on my Framework 16 laptop. The QR code scanning consistently failed.

**Analysis:**
The root cause appears to be a hardware limitation on certain webcams. The issue is a combination of the camera's fixed minimum focus distance and the relatively small size of the QR code presented in the Shell UI. The webcam can't focus on the QR code when it's held close, and the code is too small to be read when held far enough away to be in focus.

I found a workaround by taking a photo of the QR code on my phone, zooming in on the photo, and then presenting it to the webcam. This worked immediately.

**Broader Impact & Research:**
This problem is likely not limited to Framework. My research indicates a clear divide in webcam performance based on the laptop's hardware:

* **Laptops with an NPU (Neural Processing Unit):** Models like modern Apple MacBooks, Microsoft Surface, Dell XPS, HP Spectre, and high-end Lenovo ThinkPads use aggressive software processing. This allows them to recognize QR codes even when slightly out of focus or at a distance.

* **Laptops without an NPU:** Models like the Framework, TUXEDO Computers, Slimbook, and standard business lines (Lenovo ThinkPad T/L-series, Dell Latitude 5000/7000 series, HP EliteBook 600/800 series) use more standard webcams and are highly likely to face the same issue.

**Suggested Next Steps:**
1.  **UI Enhancement:** Can we explore options to make the QR code significantly larger on the Keycard Shell screen? This seems like the most direct fix for our users. @bitgamma
2.  **QA & Documentation:** We should log this behaviour and expand our hardware testing to include some of the non-NPU laptops mentioned above to confirm the scope of the problem.

Let me know your thoughts.

romanzac, 2025-09-29:
Hi @xAlisher I would like to add:
- When I had problems with QR code recognition, I tried a trick from photography: Hold Shell with both hands at the best focus point. Stop breathing. Wait for recognition. I've logged [problems with Rabby even on my Macbook Pro M4](https://www.notion.so/3rd-Party-Wallet-Integration-Tests-22b8f96fb65c80faa06fcc195373624b), so I am not sure the degree of NPU impact. It could be also camera resolution, room light and other factors which could affect recognition.
- Increasing size of the QR code would probably make it more readable also for security cameras in the room. I would be cautious here. This could be solved with display not being readable from wide angle. QR recognition could be further enhanced with backlight. Not sure where the threshold may sit. I'm open to experiment.
- I'm open to purchase suggested laptop - Taiwan has good prices - It won't burn a lot from project bugdet.
