status-im/keycard-pro/hw/elec_/schematic_card_reader.pdf

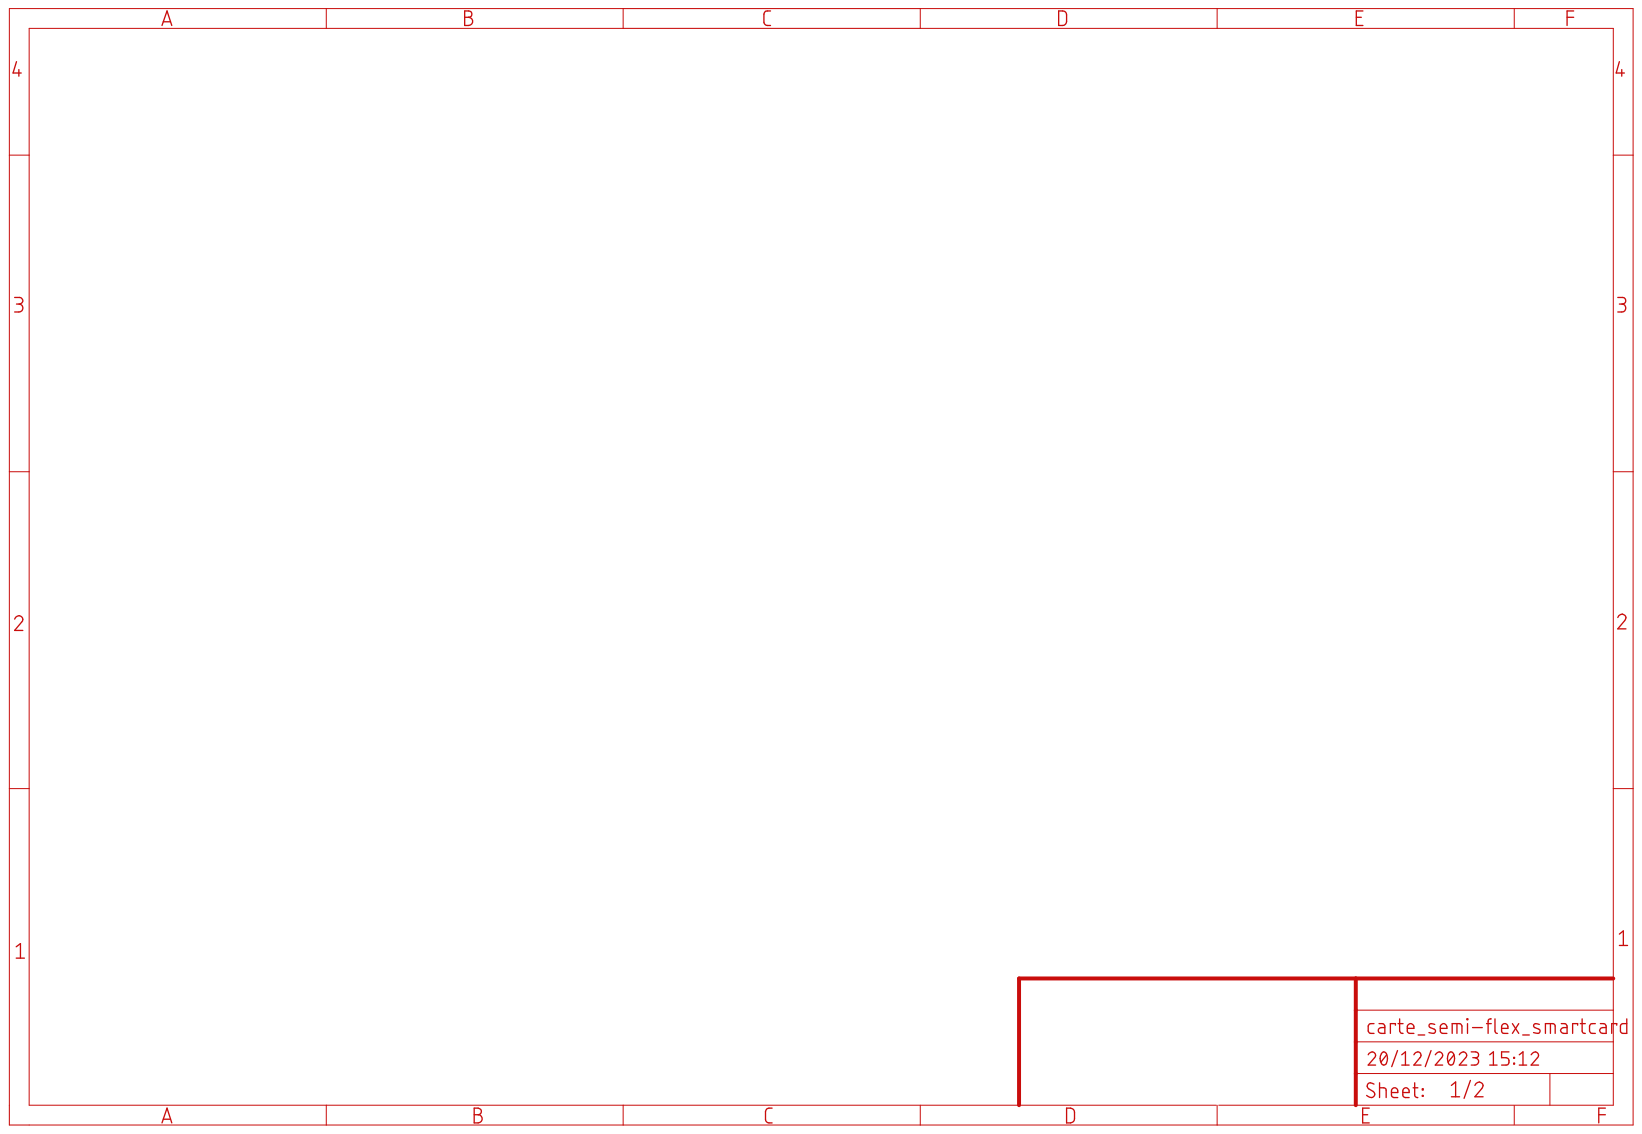
[picture p1: page 1]

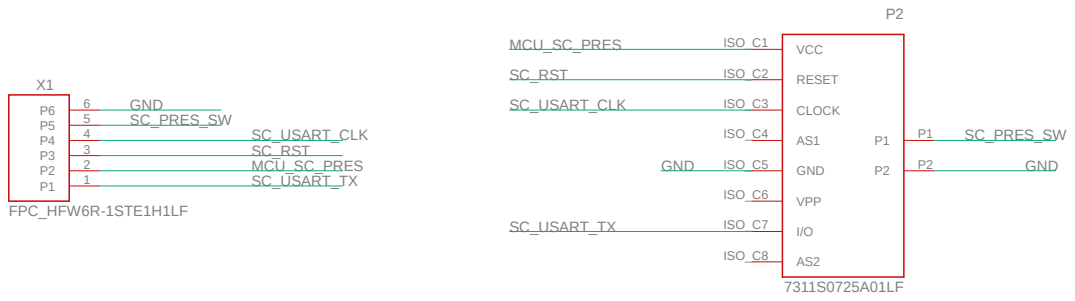
[picture p2: page 2]
FPC_HFW6R-1STE1H1LF; VCC ISO_C1; RESET ISO_C2; CLOCK ISO_C3; AS1 ISO_C4; GND ISO_C5; VPP ISO_C6; I/O ISO_C7; AS2 ISO_C8; MCU_SC_PRES; SC_RST; SC_USART_CLK; GND; SC_USART_TX; SC_PRES_SW
