status-im/keycard-pro/hw/elec_/schematic_motherboard_v2.pdf

# Sommaire

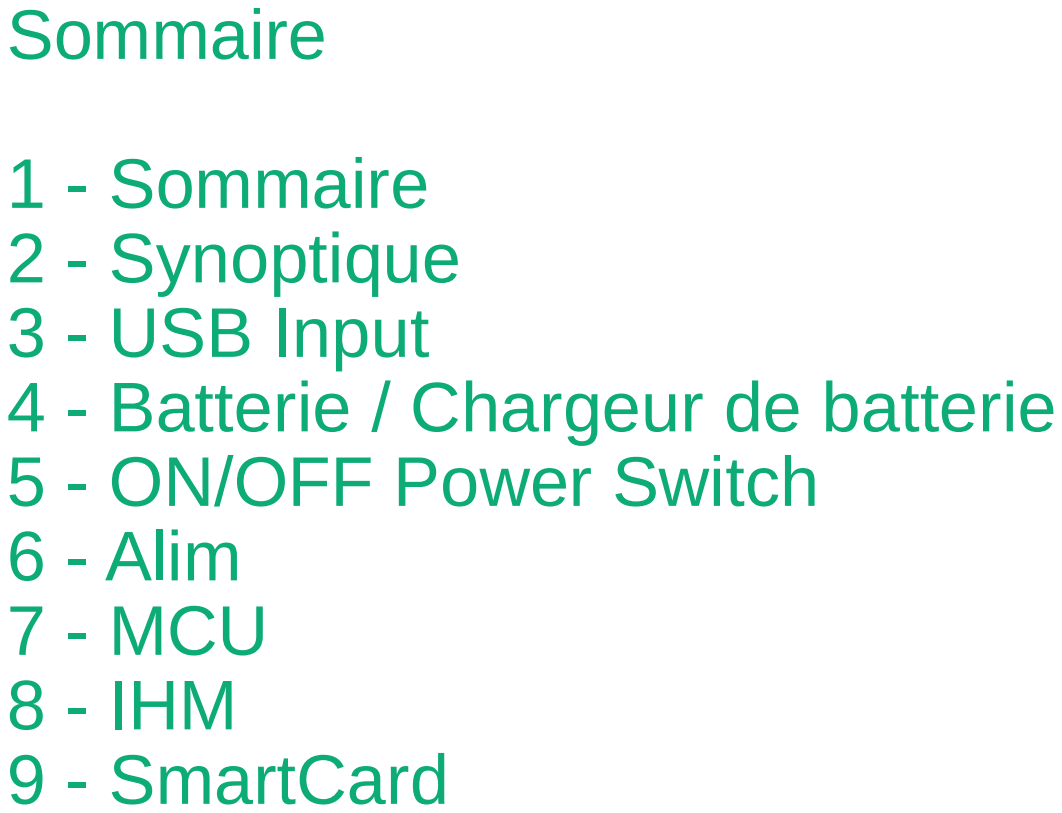
[picture p3: page 1]
Sommaire

1 - Sommaire
2 - Synoptique
3 - USB Input
4 - Batterie / Chargeur de batterie
5 - ON/OFF Power Switch
6 - Alim
7 - MCU
8 - IHM
9 - SmartCard

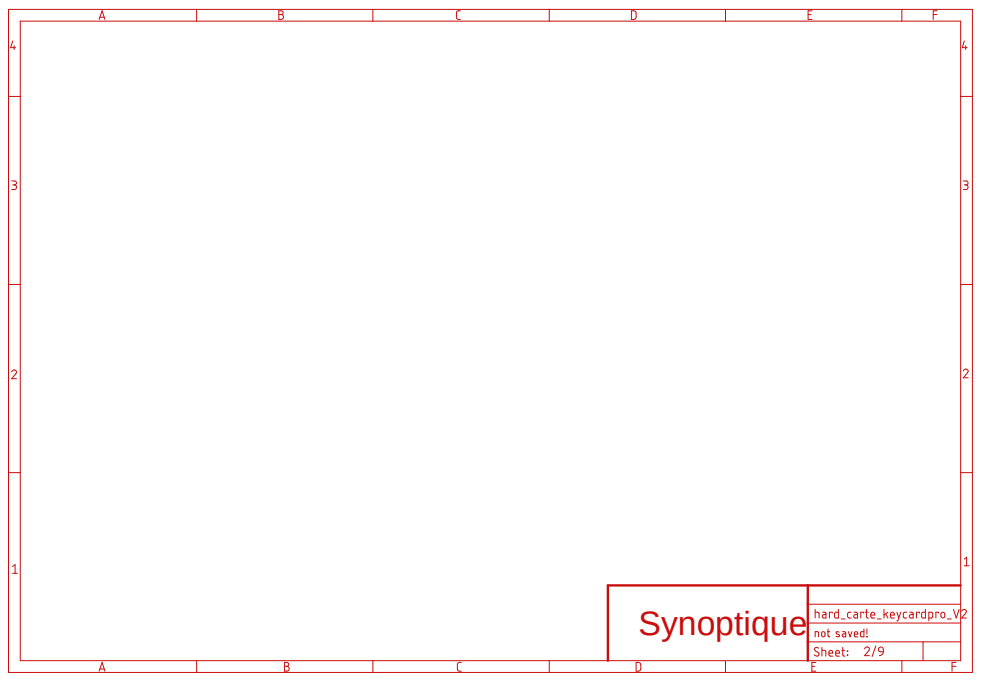
[picture p4: page 2]
Synoptique

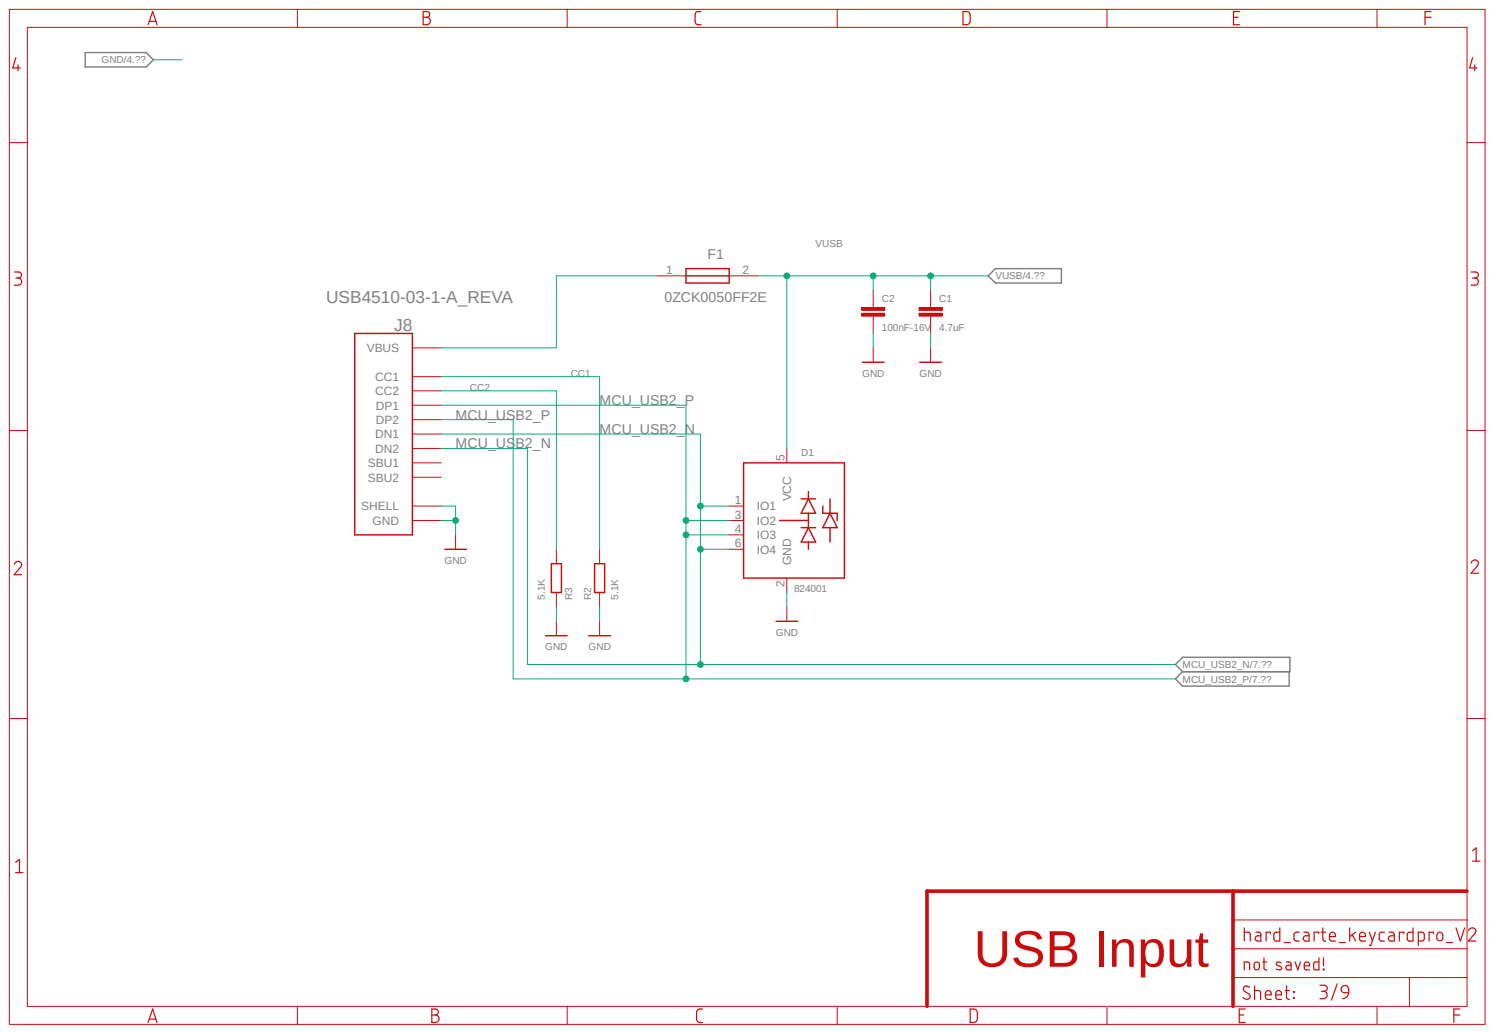
[picture p5: page 3]
GND; GND ⁵.1K GND; USB4510-03-1-A_REVA; 0ZCK0050FF2E; 2 VCC; VBUS; CC1 CC2 DP1 DP2 DN1 DN2 SBU1 SBU2; SHELL; GND/4.??; MCU_USB2_P/7.??; MCU_USB2_P; MCU_USB2_N/7.??; MCU_USB2_N; VUSB/4.??; VUSB; USB Input

1982633-1

## 0ZCK0075FF2E

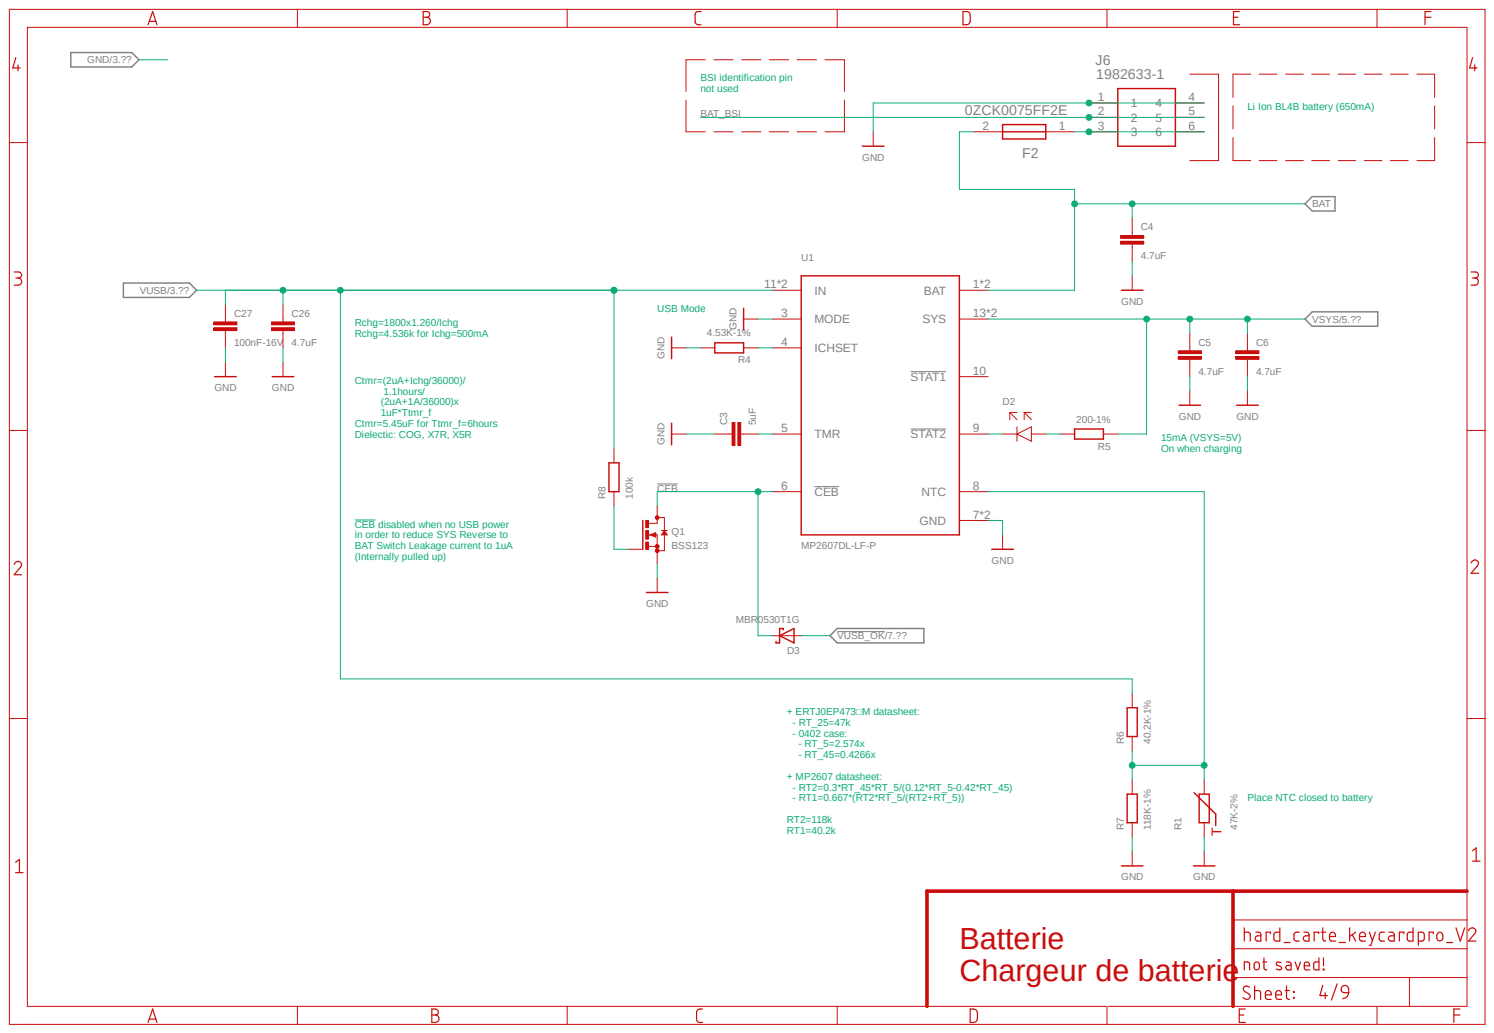
[picture p6: page 4]

GND GND
USB Mode

CEB disabled when no USB power
in order to reduce SYS Reverse to
BAT Switch Leakage current to 1uA
(Internally pulled up)

Place NTC closed to battery

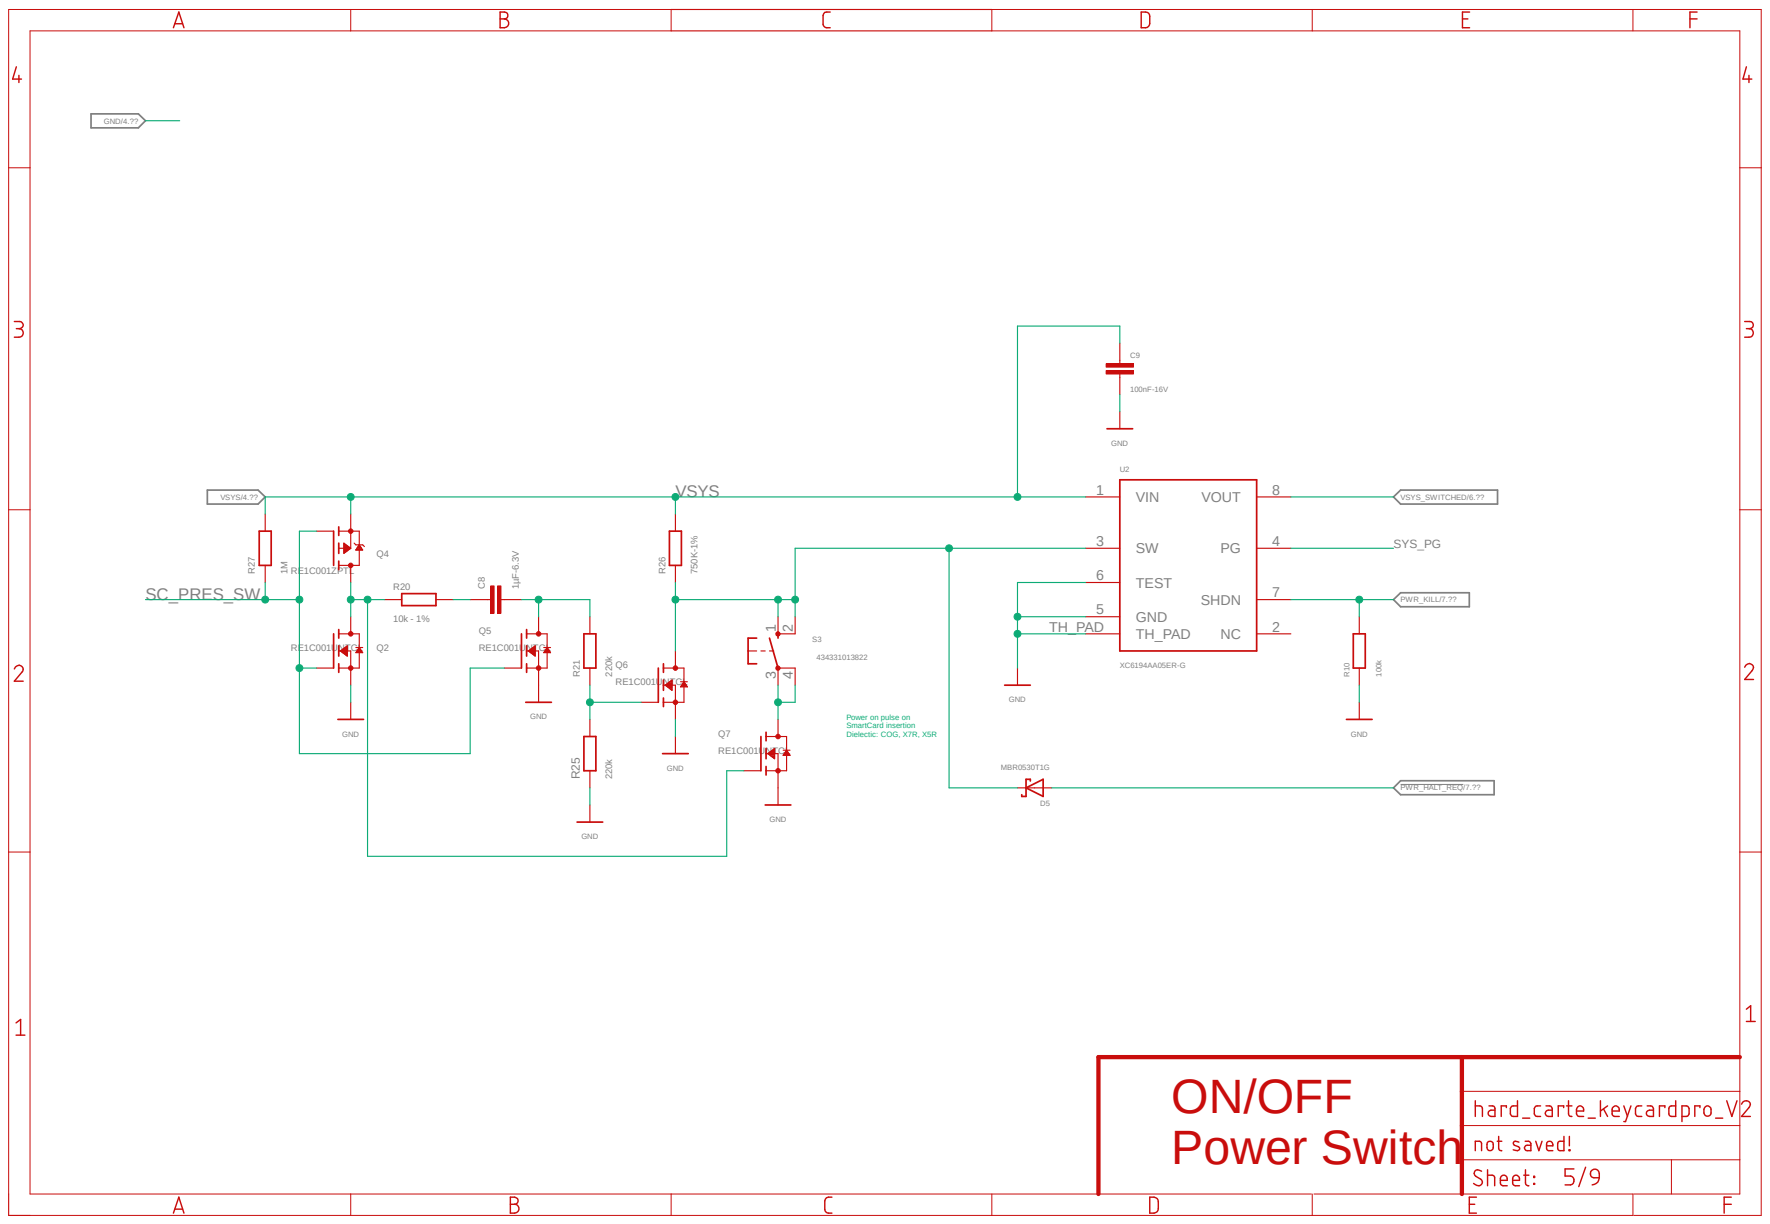
[picture p7: page 5]

Power on pulse on
SmartCard insertion
Dielectic: COG, X7R, X5R

# NCP115AMX280TCG ¹µF 6.3V

# OUT 1 U9 C⁷

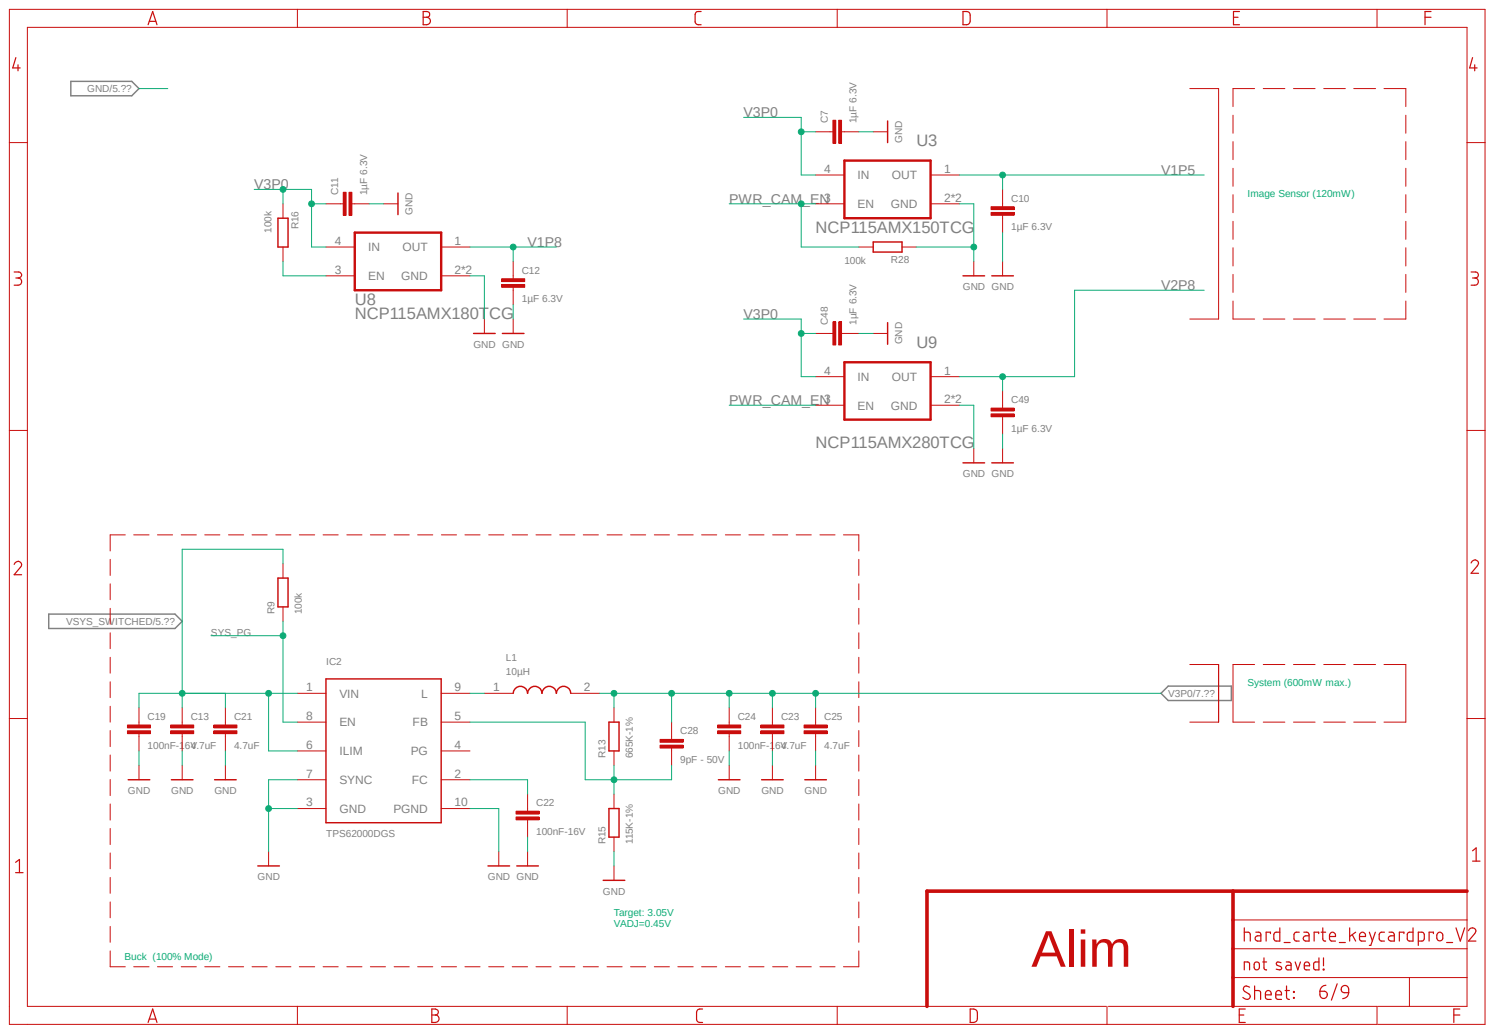
[picture p8: page 6]

1 of 3 | 2 of 3
STM32H573VIT6 | STM32H573VIT6

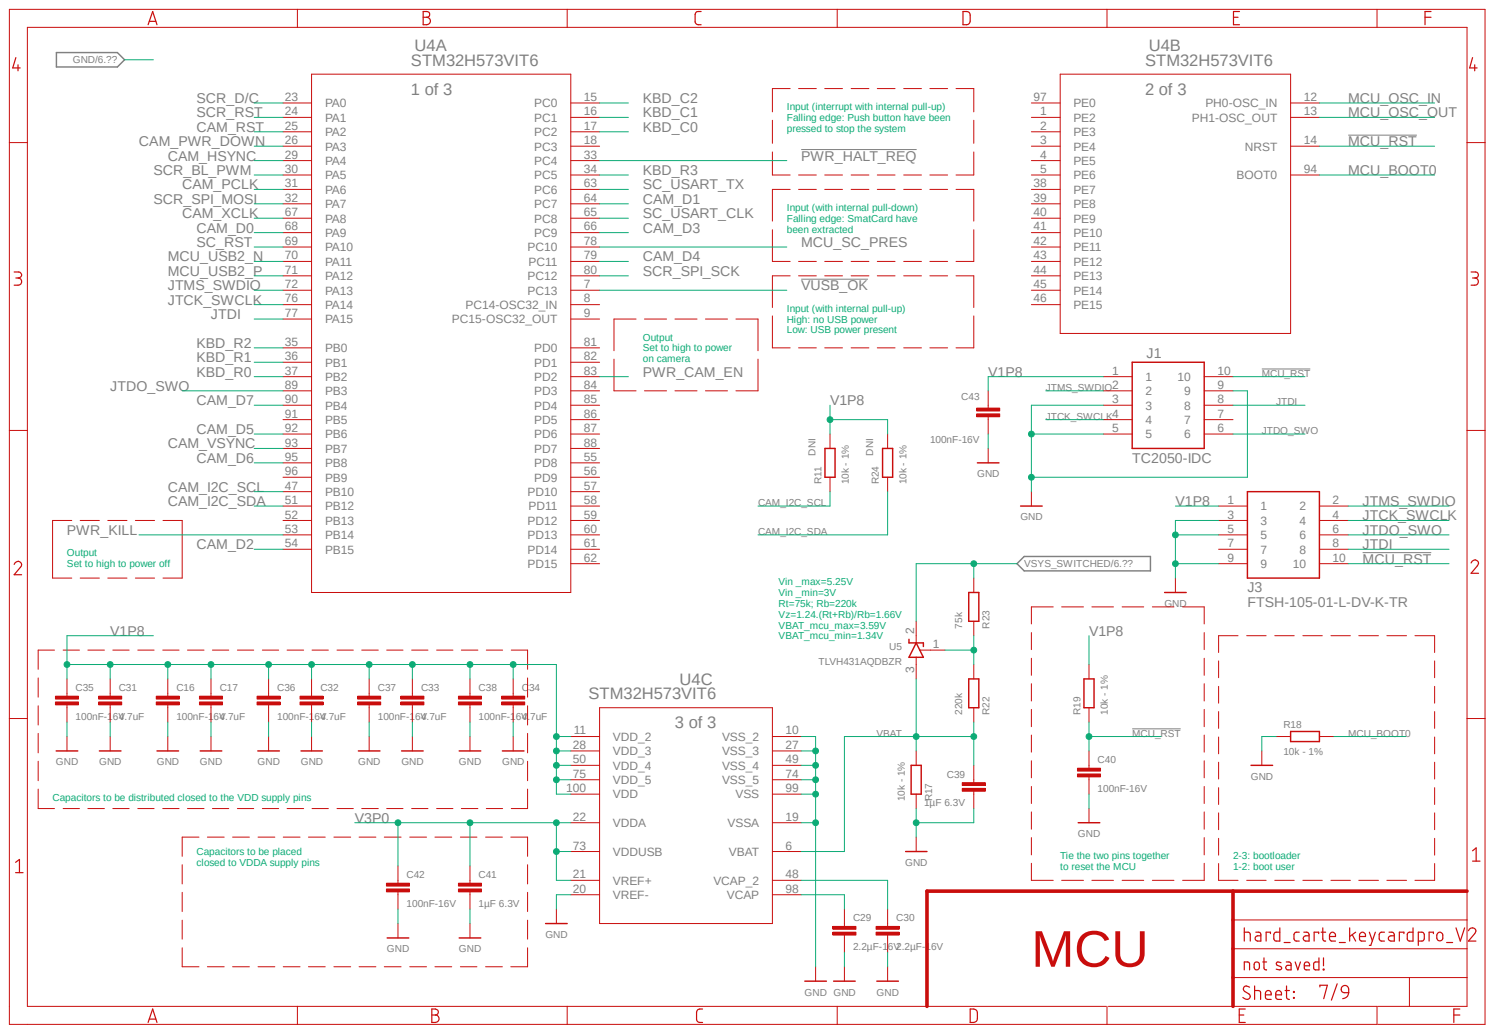
[picture p9: page 7]

Input (interrupt with internal pull-up)
Falling edge: Push button have been
pressed to stop the system
PWR_HALT_REQ

Input (with internal pull-down)
Falling edge: SmatCard have
been extracted
MCU_SC_PRES

Input (with internal pull-up)
High: no USB power
Low: USB power present

Output
Set to high to power
on camera
PWR_CAM_EN

5 | 6 JTDO_SWO
7 | 8 JTDI

Set to high to power off

Capacitors to be distributed closed to the VDD supply pins

Capacitors to be placed
closed to VDDA supply pins

Tie the two pins together
to reset the MCU

V1P8

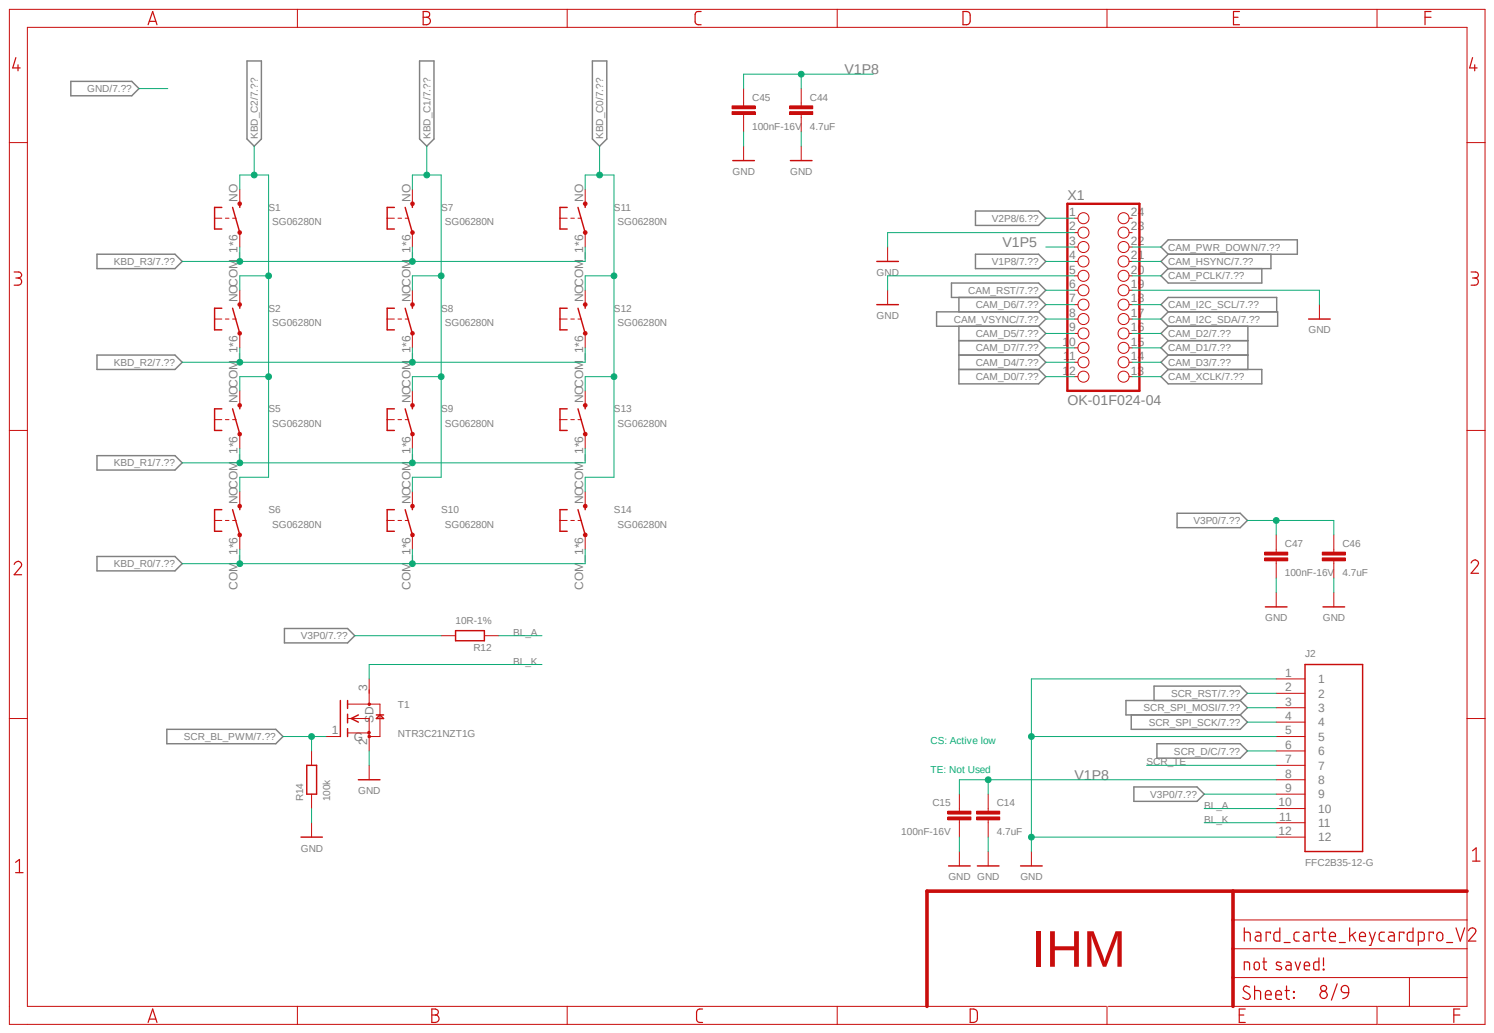
[picture p10: page 8]

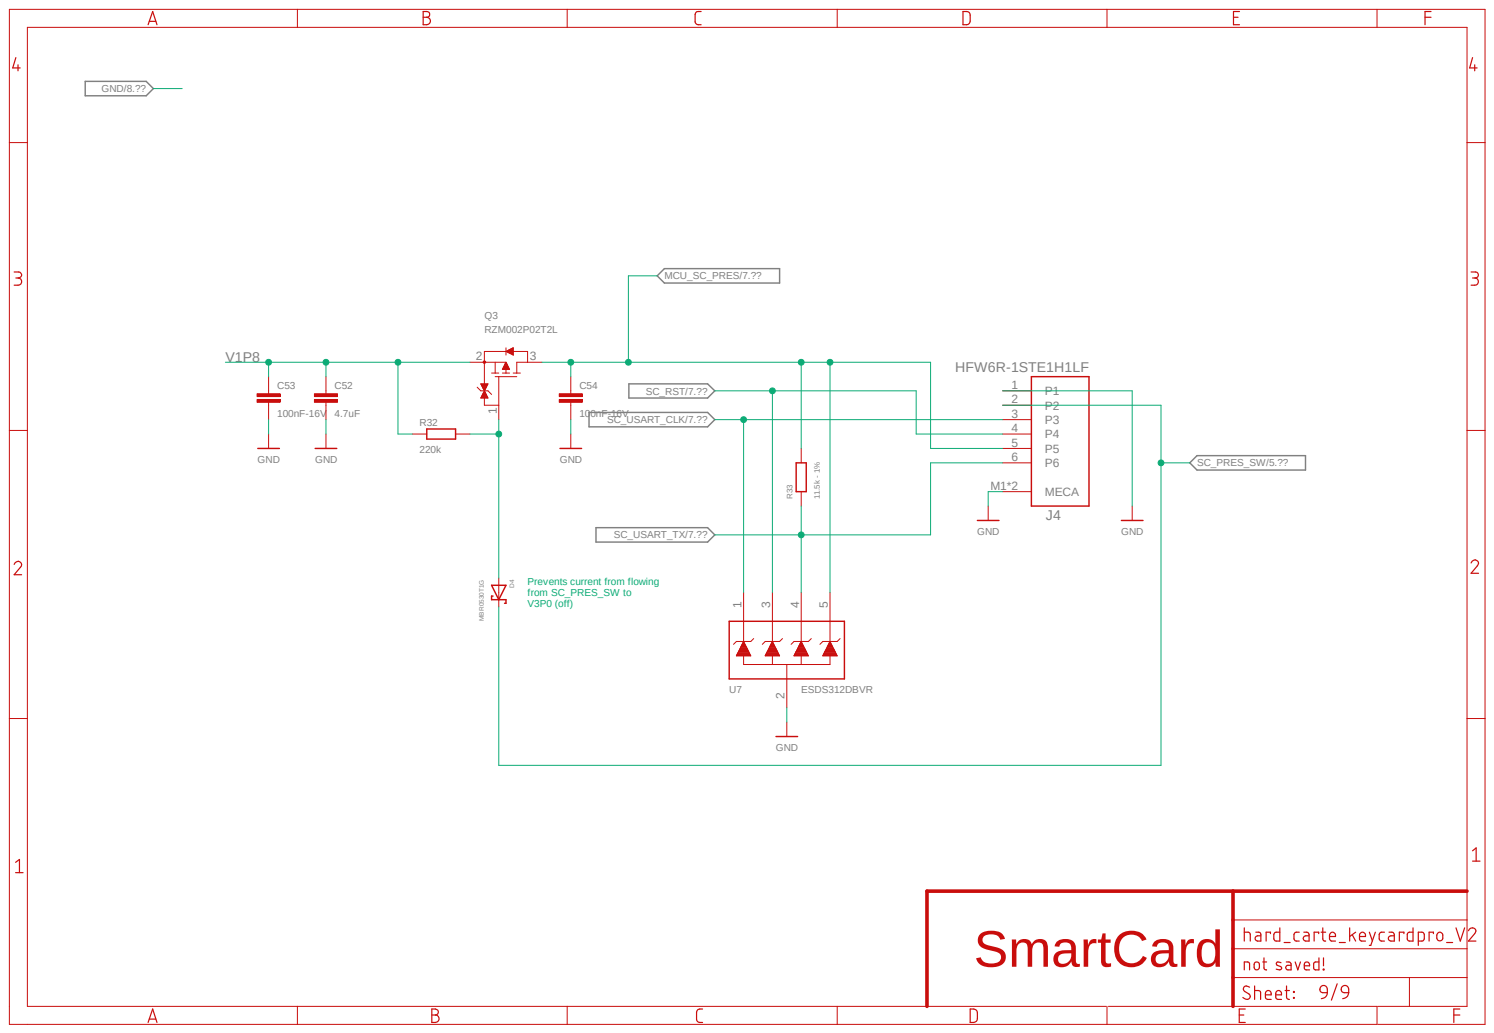
[picture p11: page 9]

Prevents current from flowing
from SC_PRES_SW to
V3P0 (off)
