status-im/keycard-pro/stm32/stm32.ioc

Mcu.UserName=STM32H573VITx
PA0.GPIO_Label=GPIO_LCD_CD
PA0.Signal=GPIO_Output
PA1.GPIO_Label=GPIO_LCD_RST
PA1.Signal=GPIO_Output
PA10.GPIO_Label=GPIO_CARD_RST
PA10.Signal=GPIO_Output
PA11.Signal=USB_DM
PA12.Signal=USB_DP
PA13(JTMS/SWDIO).GPIO_Label=SWDIO
PA13(JTMS/SWDIO).Signal=DEBUG_JTMS-SWDIO
PA14(JTCK/SWCLK).GPIO_Label=SWCLK
PA14(JTCK/SWCLK).Signal=DEBUG_JTCK-SWCLK
PA2.GPIO_Label=GPIO_CAMERA_RST
PA2.Signal=GPIO_Output
PA3.GPIO_Label=GPIO_CAMERA_PWDN
PA3.Signal=GPIO_Output
PA4.Signal=DCMI_HSYNC
PA5.GPIO_Label=PWM_LCD_BL
PA5.Signal=S_TIM2_CH1
PA6.Signal=DCMI_PIXCLK
PA7.Signal=SPI6_MOSI
PA8.GPIO_Label=CAM_XCLK
PA8.Signal=RCC_MCO_1
PA9.Signal=DCMI_D0
PB0.GPIO_Label=GPIO_KEYPAD_ROW_1
PB0.Signal=GPIO_Output
PB1.GPIO_Label=GPIO_KEYPAD_ROW_2
PB1.Signal=GPIO_Output
PB10.Signal=I2C2_SCL
PB12.Signal=I2C2_SDA
PB14.GPIO_Label=GPIO_PWR_KILL
PB14.Signal=GPIO_Output
PB15.Signal=DCMI_D2
PB2.GPIO_Label=GPIO_KEYPAD_ROW_3
PB2.Signal=GPIO_Output
PB3(JTDO/TRACESWO).GPIO_Label=SWO
PB3(JTDO/TRACESWO).Signal=DEBUG_JTDO-SWO
PB4(NJTRST).Signal=DCMI_D7
PB6.Signal=DCMI_D5
PB7.Signal=DCMI_VSYNC
PB8.Signal=DCMI_D6
PC0.GPIO_Label=GPIO_KEYPAD_COL_2
PC0.Signal=GPIO_Input
PC1.GPIO_Label=GPIO_KEYPAD_COL_1
PC1.Signal=GPIO_Input
PC10.GPIO_Label=GPIO_SC_PRES
PC10.Signal=GPXTI10
PC11.Signal=DCMI_D4
PC12.Signal=SPI6_SCK
PC13.GPIO_Label=GPIO_VUSB_OK
PC13.Signal=GPXTI13
PC2.GPIO_Label=GPIO_KEYPAD_COL_0
PC2.Signal=GPIO_Input
PC4.GPIO_Label=GPIO_HALT_REQ
PC4.Signal=GPXTI4
PC5.GPIO_Label=GPIO_KEYPAD_ROW_0
PC5.Signal=GPIO_Output
PC6.Signal=USART6_TX
PC7.Signal=DCMI_D1
PC8.Signal=USART6_CK
PC9.Signal=DCMI_D3
PD2.GPIO_Label=GPIO_CAM_EN
PD2.Signal=GPIO_Output
