status-im/keycard-pro/stm32/Core/Inc/main.h

#define KEYPAD_POLL_MS 5
#define SC_DEFAULT_PSC 25
#define SC_DEFAULT_BAUD_RATE 10752
#define HALT_REQ_MS 10
#define GPIO_VUSB_OK_Pin GPIO_PIN_13
#define GPIO_VUSB_OK_GPIO_Port GPIOC
#define GPIO_VUSB_OK_EXTI_IRQn EXTI13_IRQn
#define GPIO_KEYPAD_COL_2_Pin GPIO_PIN_0
#define GPIO_KEYPAD_COL_2_GPIO_Port GPIOC
#define GPIO_KEYPAD_COL_1_Pin GPIO_PIN_1
#define GPIO_KEYPAD_COL_1_GPIO_Port GPIOC
#define GPIO_KEYPAD_COL_0_Pin GPIO_PIN_2
#define GPIO_KEYPAD_COL_0_GPIO_Port GPIOC
#define GPIO_LCD_CD_Pin GPIO_PIN_0
#define GPIO_LCD_CD_GPIO_Port GPIOA
#define GPIO_LCD_RST_Pin GPIO_PIN_1
#define GPIO_LCD_RST_GPIO_Port GPIOA
#define GPIO_CAMERA_RST_Pin GPIO_PIN_2
#define GPIO_CAMERA_RST_GPIO_Port GPIOA
#define GPIO_CAMERA_PWDN_Pin GPIO_PIN_3
#define GPIO_CAMERA_PWDN_GPIO_Port GPIOA
#define PWM_LCD_BL_Pin GPIO_PIN_5
#define PWM_LCD_BL_GPIO_Port GPIOA
#define GPIO_HALT_REQ_Pin GPIO_PIN_4
#define GPIO_HALT_REQ_GPIO_Port GPIOC
#define GPIO_HALT_REQ_EXTI_IRQn EXTI4_IRQn
#define GPIO_KEYPAD_ROW_0_Pin GPIO_PIN_5
#define GPIO_KEYPAD_ROW_0_GPIO_Port GPIOC
#define GPIO_KEYPAD_ROW_1_Pin GPIO_PIN_0
#define GPIO_KEYPAD_ROW_1_GPIO_Port GPIOB
#define GPIO_KEYPAD_ROW_2_Pin GPIO_PIN_1
#define GPIO_KEYPAD_ROW_2_GPIO_Port GPIOB
#define GPIO_KEYPAD_ROW_3_Pin GPIO_PIN_2
#define GPIO_KEYPAD_ROW_3_GPIO_Port GPIOB
#define GPIO_PWR_KILL_Pin GPIO_PIN_14
#define GPIO_PWR_KILL_GPIO_Port GPIOB
#define CAM_XCLK_Pin GPIO_PIN_8
#define CAM_XCLK_GPIO_Port GPIOA
#define GPIO_CARD_RST_Pin GPIO_PIN_10
#define GPIO_CARD_RST_GPIO_Port GPIOA
#define SWDIO_Pin GPIO_PIN_13
#define SWDIO_GPIO_Port GPIOA
#define SWCLK_Pin GPIO_PIN_14
#define SWCLK_GPIO_Port GPIOA
#define GPIO_SC_PRES_Pin GPIO_PIN_10
#define GPIO_SC_PRES_GPIO_Port GPIOC
#define GPIO_SC_PRES_EXTI_IRQn EXTI10_IRQn
#define GPIO_CAM_EN_Pin GPIO_PIN_2
#define GPIO_CAM_EN_GPIO_Port GPIOD
#define SWO_Pin GPIO_PIN_3
#define SWO_GPIO_Port GPIOB
