status-im/keycard-pro/(commit log)

2022-09-08 add spi + example
2022-09-08 disable unused PIN
2022-10-04 pin verify
2022-11-04 export real chain code
2023-03-07 extract camera driver
2023-03-14 fix camera driver
2023-03-24 start screen driver implementation
2023-03-27 start implementation of camera passthrough
2023-03-27 change camera passthrough
2023-03-27 correctly scale height of camera fb
2023-03-28 add dma
2023-03-28 temp fix for DMA driver
2023-04-12 center camera output
2023-04-12 make sure old frames are not processed
2023-04-13 switch to rectangular screen
2023-04-21 use stack instead of camera buffer
2023-04-28 start stm32 port
2023-05-02 continue stm32 port implementation
2023-05-07 fix dma settings
2023-05-07 fix spi prio
2023-05-07 improve dma configuration for DCMI
2023-05-10 manage camera clock
2023-05-10 change dma channels
2023-05-10 fix stack overflow and unaligned accesses
    [core_task.c, main.c, qrcode.c]
2023-05-11 use internal rc oscillator
    [main.c, main.h, stm32.c, stm32.ioc]
2023-05-17 add fingerprint
2023-05-18 use correct path for signing
    [core.c]
2023-05-22 fix random double generation
    [xoshiro256.c]
2023-05-23 make default case explicit
2023-05-29 add pin entry
2023-05-30 implement pin creation
2023-07-03 remove internal chain id
2023-07-04 add chain id to tx for display
2023-07-05 add chain display
2023-07-05 fix chain data read
2023-07-06 set a default chain id
2023-07-18 improve bip39 loading flow
2023-07-19 remove redundant pin input on card init
2023-07-24 fixes to db update
    [fs.c, mem.c, mem.h]
2023-07-25 fix timeout in hal_flash_program
    [stm32.c]
2023-07-26 add current timestamp
2023-08-21 board v1 port
2023-08-22 configure interrupts and adc
2023-08-22 start power management
2023-08-24 adapt to new board
2023-08-25 give clocks time to stabilize
    [stm32.c]
2023-09-03 fix events breaking when handling usb commands
    [ui_task.c]
2023-09-04 allow button repeat
2023-09-06 remove poweroff menu
2023-09-07 fix message and add eip712 via usb
    [core.c]
2023-09-14 add inactivity timer
2023-09-14 finish poweroff implementation
2023-09-15 make usb switchable
2023-09-19 implement change pin
2023-09-20 implement battery gauge
2023-09-20 use oversampling for battery gauge
2023-09-22 fix camera in release build
2023-09-26 fix dialog back/ok handling
    [card.c, dialog.c, ui.c]
2023-10-03 fix bootcmd allocation directives
    [mem.c]
2023-10-19 implement proper battery readings
2023-10-25 fix backlight pwm scaling
    [stm32.c]
2023-11-03 add device info
2023-11-03 fingerprint in qr code
2023-11-30 correct source fingerprint
2023-12-06 add fingerprint verification
2024-01-30 fixes to VUSB_OK and PWR_HALT_REQ
    [main.c, main.h, stm32.c, stm32.ioc]
2024-02-01 workaround screen freeze issue
    [main.c, st7789.c]
2024-02-08 correct ecdsa signature verification
    [bootloader.c, stm32_crypto.c]
2024-02-09 add device-unique key derivation
2024-02-13 fix mnemonic backup word selection
    [input.c, rand.c, rand.h]
2024-02-14 add serial number to device info
2024-02-16 change battery monitor parameters
2024-02-16 move battery measurement code
2024-02-19 modify test app to read battery status
2024-02-20 handle full pairing slots state
2024-03-11 add wrong pin/puk messages
    [english.c, i18n.h, ui.c]
2024-03-25 use icon for battery indicator
2024-03-26 change battery icons
2024-04-12 add some error messages
    [auth.c, core.c, english.c, i18n.h, input.c]
2024-04-12 fix usb message reassemble
    [core.c, main.c]
2024-04-23 fix small ui glitch
    [dialog.c, dialog.h, input.c]
2024-05-06 fix #6.303 object encoding
    [core.c, core.h]
2024-05-07 fix memory handling and add actual sn
    [core.c]
2024-05-17 improved PIN entry
2024-05-17 make pin creation in two steps
2024-05-21 better pin repeat comparison
2024-05-30 add nav hints to PIN entry
2024-06-25 add psbt (de)serializer
2024-07-10 new version
    [BOM.csv]
2024-07-11 fix nested segwit support
    [core_btc.c]
